Yourigh/A_light/4 - Mechanical/source_models_/esp8266-e12-1.snapshot.4/ESP8266 single.jpg

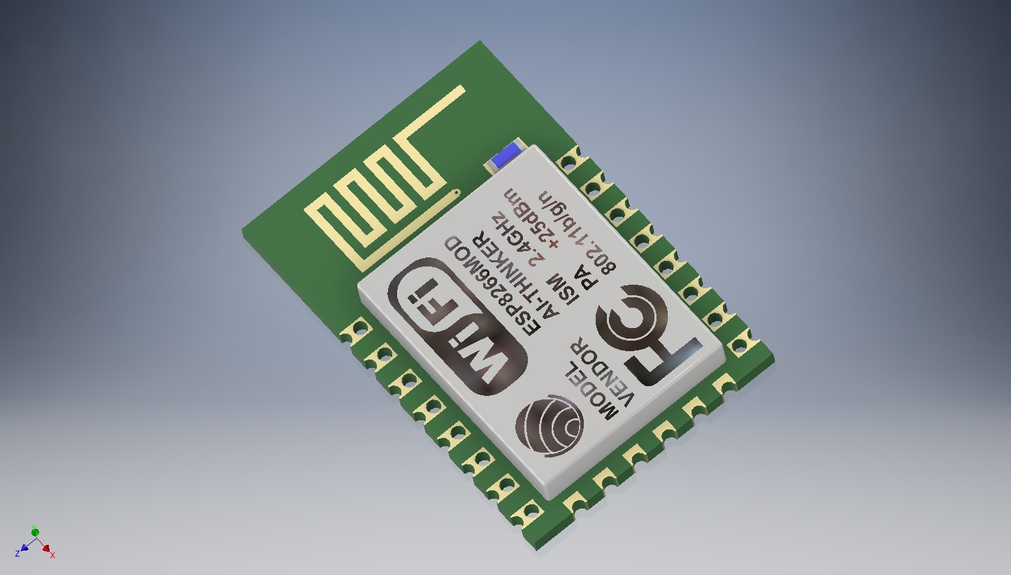
4 - Mechanical/source_models_/esp8266-e12-1.snapshot.4/ESP8266 single.jpg
