Yourigh/A_light/4 - Mechanical/source_models_/header-female-1.snapshot.4/Header Female 1x16.JPG

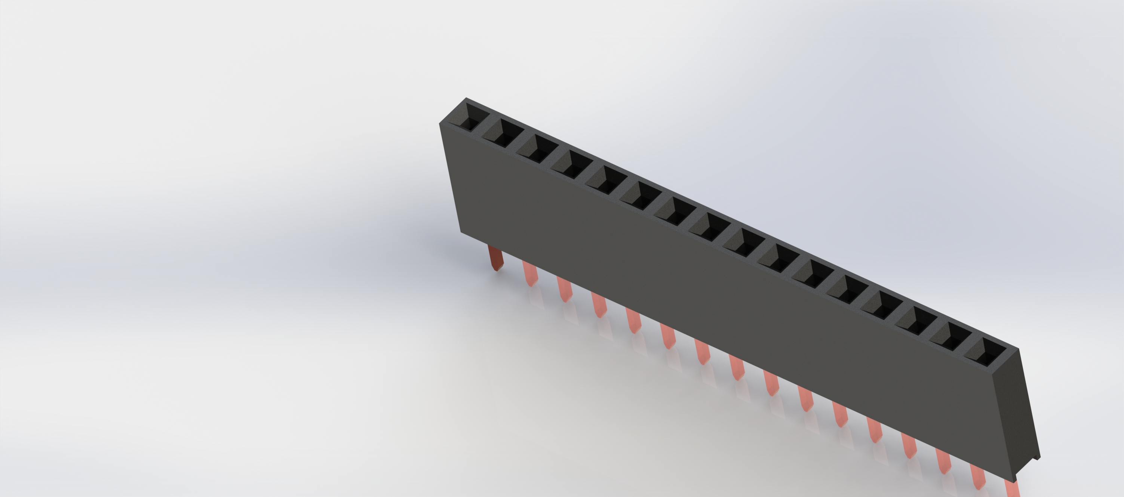
4 - Mechanical/source_models_/header-female-1.snapshot.4/Header Female 1x16.JPG
