Yourigh/A_light/4 - Mechanical/03ClockFace/clock face drawing v2.pdf

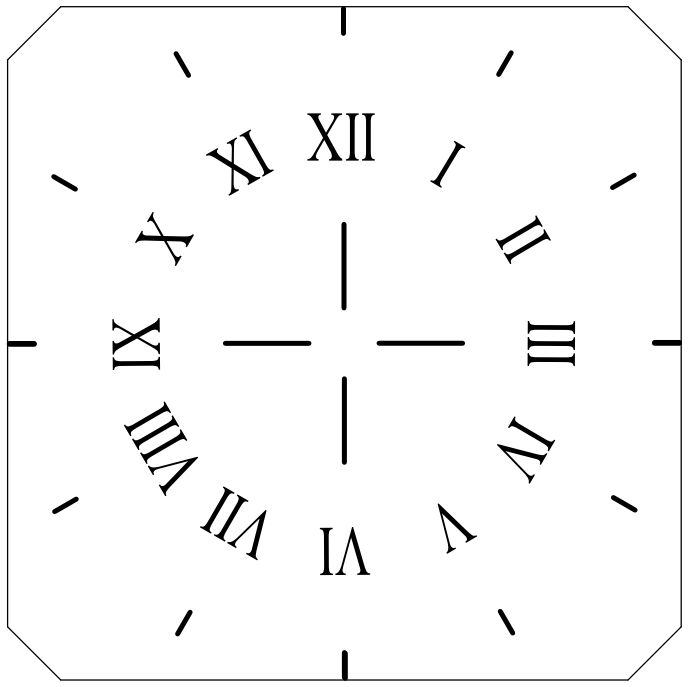
[picture p3: figure]
XII I; II III; VIII IX
