Yourigh/A_light/4 - Mechanical/03ClockFace/clock face drawing v3 latin.pdf

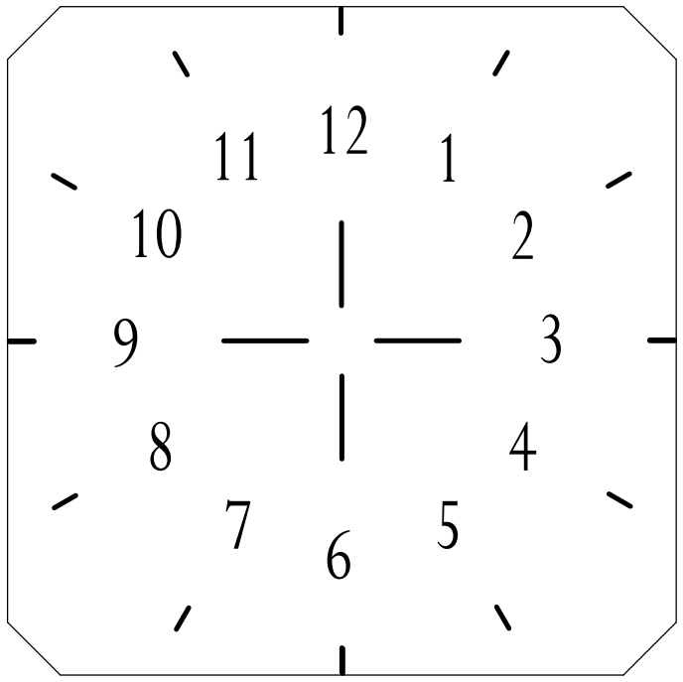
[picture p4: figure]
11 XII I; II III; VIII IX
