Yourigh/A_light/4 - Mechanical/03ClockFace/clock face drawing v3 lines.pdf

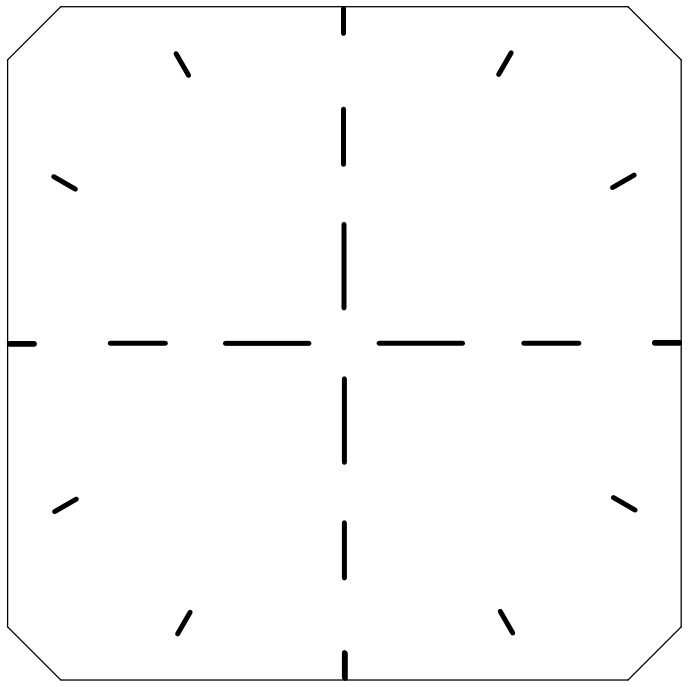
[picture p5: figure]
11 XII I; II III; VIII IX
