Yourigh/A_light/4 - Mechanical/03ClockFace/clock face drawing v3 transparency.pdf

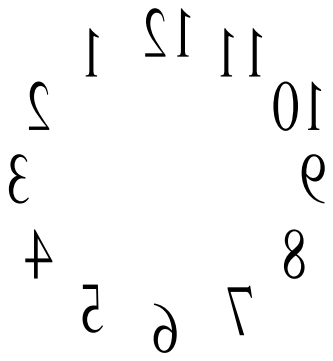
[picture p6: figure]
XII I; II III; VIII IX
