Yourigh/A_light/4 - Mechanical/03ClockFace/clock-face-drawing_small.png

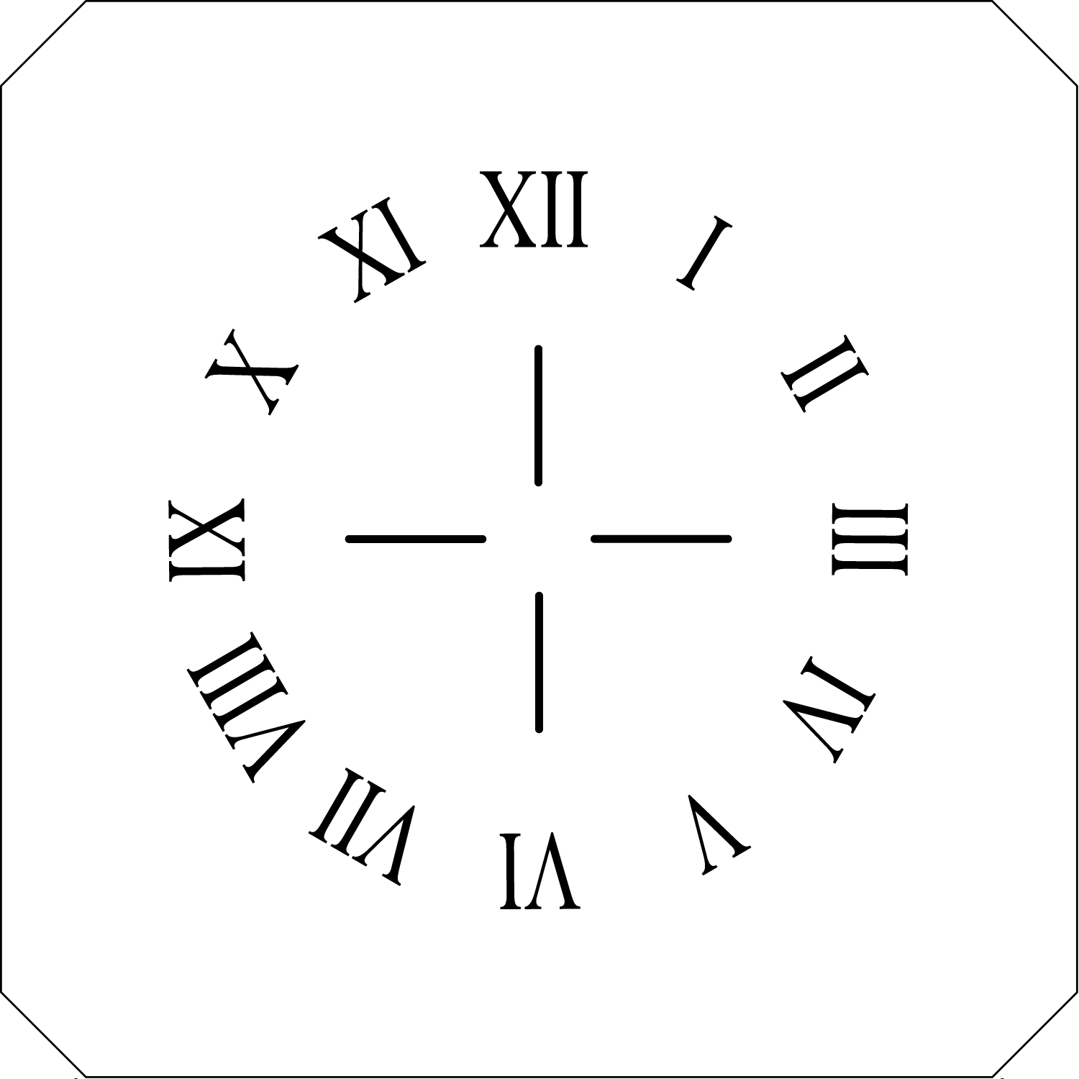
4 - Mechanical/03ClockFace/clock-face-drawing_small.png
