Yourigh/A_light/4 - Mechanical/source_models_/adafruit-24-led-neo-pixel-ring-1.snapshot.2/Renderings/24 neopixel.JPG

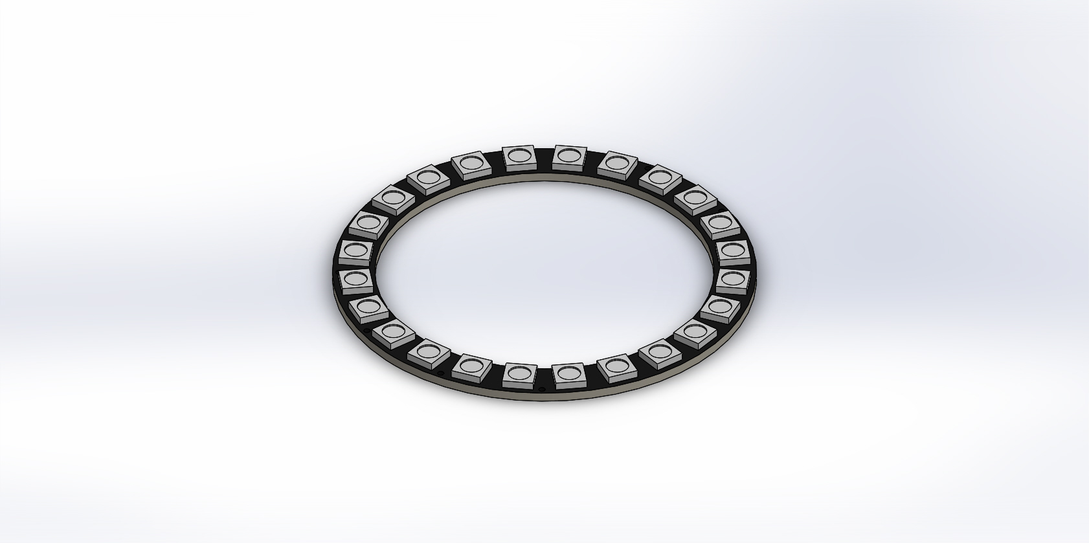
4 - Mechanical/source_models_/adafruit-24-led-neo-pixel-ring-1.snapshot.2/Renderings/24 neopixel.JPG
