Yourigh/A_light/4 - Mechanical/source_models_/adafruit-neopixel-ring-12x-ws2812-rgb-leds-1.snapshot.1/top.PNG

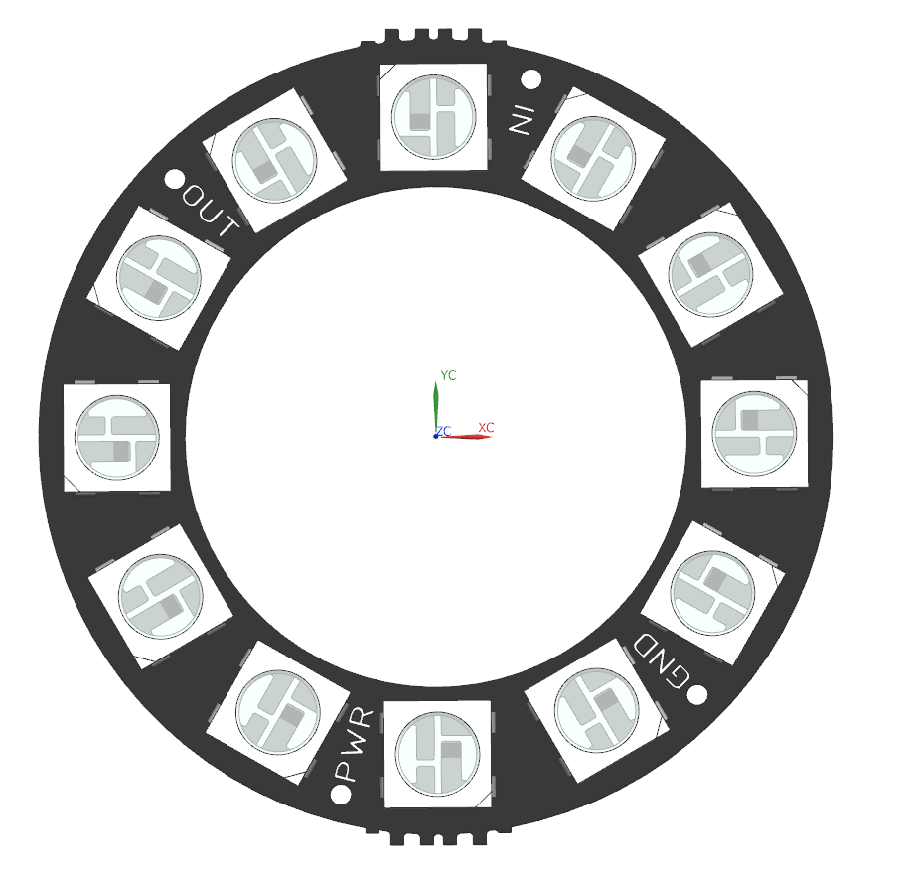
4 - Mechanical/source_models_/adafruit-neopixel-ring-12x-ws2812-rgb-leds-1.snapshot.1/top.PNG
