Yourigh/A_light/4 - Mechanical/source_models_/esp32-wroom-1.snapshot.2/ESP32-EWROOM.png

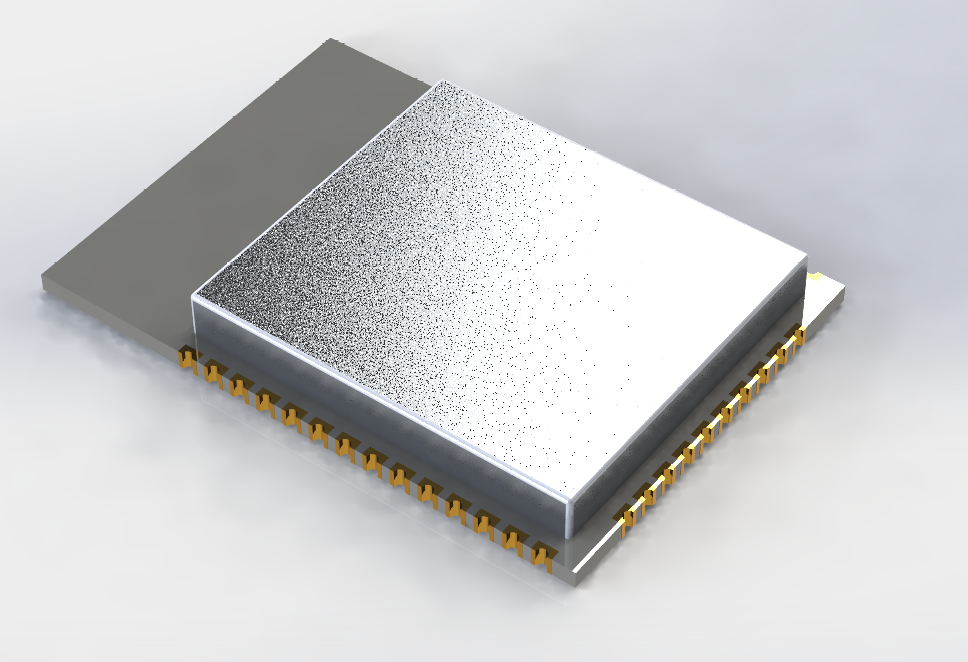
4 - Mechanical/source_models_/esp32-wroom-1.snapshot.2/ESP32-EWROOM.png
