Yourigh/A_light/4 - Mechanical/source_models_/header-female-1.snapshot.4/Renderings/Header Female 1x10.JPG

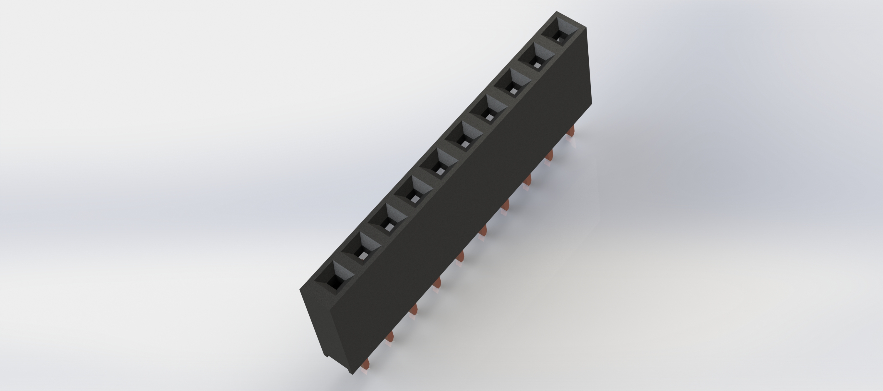
4 - Mechanical/source_models_/header-female-1.snapshot.4/Renderings/Header Female 1x10.JPG
