Yourigh/A_light/4 - Mechanical/source_models_/led-smd-rgb-ws2812-1.snapshot.1/LED - SMD RGB (WS2812).PNG

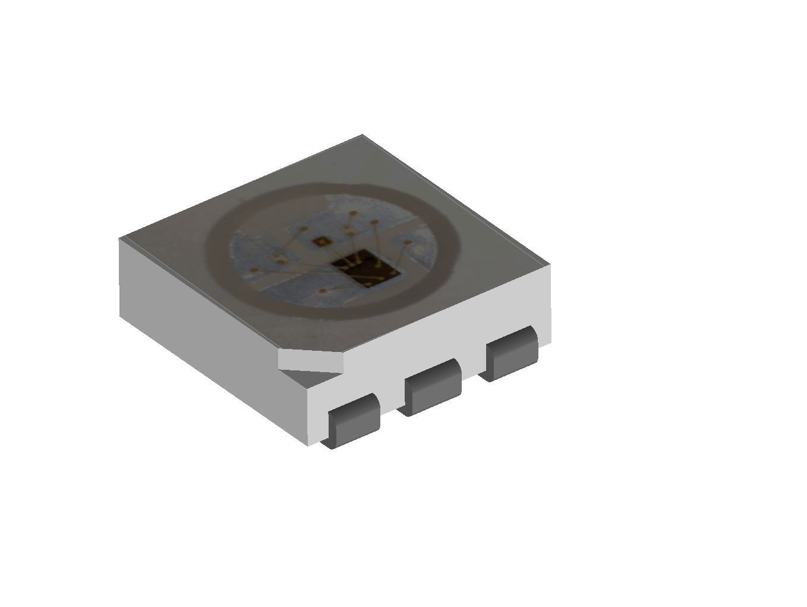
4 - Mechanical/source_models_/led-smd-rgb-ws2812-1.snapshot.1/LED - SMD RGB (WS2812).PNG
