Yourigh/A_light/4 - Mechanical/source_models_/micro-usb-dip-5-pin-pinboard-2-54mm-1.snapshot.3/MicroUSB_Pinboard_5_Pins_Back.JPG

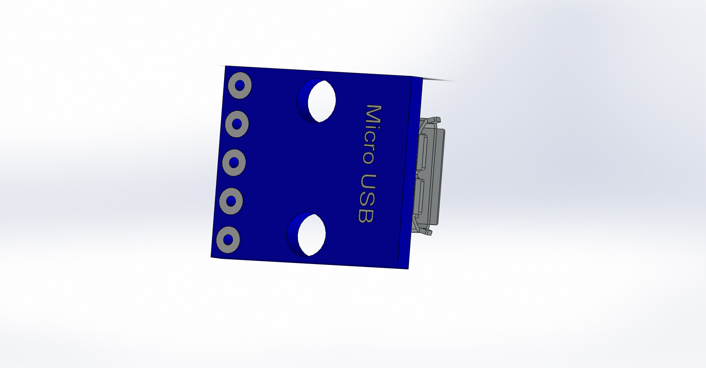
4 - Mechanical/source_models_/micro-usb-dip-5-pin-pinboard-2-54mm-1.snapshot.3/MicroUSB_Pinboard_5_Pins_Back.JPG
