Yourigh/A_light/2 - Electrical/0 - Development Drawings/2 - Main Board/2 - eeBOM/181229 Alight_eeBOM.xlsx

Sheet: OTHER_SPECIFICATIONS
Document Number and revision | Alight rev2
Document descrpition | Electrical bill of the material document for Alight rev2
Issued by | Juraj Repcik
Initial release date YY-MM-DD | 2018-12-29
Last modified by | Juraj Repcik
Last modified date date YY-MM-DD | 2018-12-29
Printed Circuit Board
PCB number and marking | -
Number of layers | 2
Material type | -
Temperature grade | -
Copper thickness | 18/35 um
Surface finishing | HAL
Soldermask TOP+BOTTOM | Green
Silkscreen - TOP | YES
Silkscreen - BOTTOM | YES
Silkscreen color | White
Electrical test | YES

Sheet: eeBOM ESP12 CH340
Qty | Value | Device | Supplier | Detail | Link | Price/pc USD | Price | Package | Parts | Description
9 | 0 | R-EU_R0603 | Farnell |  |  |  | 0 | R0603 | R8, R9, R13, R21, R22, R23, R24, R38, R55 | RESISTOR, European symbol
1 | 100k | R-EU_R0603 | Farnell |  |  |  | 0 | R0603 | R15 | RESISTOR, European symbol
8 | 100n | C-EUC0603K | Aliexpress |  | https://www.aliexpress.com/item/100pcs-1PF-10UF-0603-SMD-50V-X7R-10-100nf-104K-4-7UF-1UF-10UF-2-2UF/32883367230.html | 0.02 | 0.16 | C0603K | C1, C3, C5, C10, C13, C26, C28, C31 | CAPACITOR, European symbol
11 | 10u | C-EUC0603K | Aliexpress |  | https://www.aliexpress.com/item/100pcs-1PF-10UF-0603-SMD-50V-X7R-10-100nf-104K-4-7UF-1UF-10UF-2-2UF/32883367230.html | 0.02 | 0.22 | C0603K | C2, C4, C6, C9, C11, C12, C19, C20, C21, C22, C27 | CAPACITOR, European symbol
1 | 12MHz | CRYSTALSMD-HC49UP | Farnell | 1652551 | https://cz.farnell.com/abracon/abls-12-000mhz-b2-t/microprocessor-crystal-12mhz/dp/1652551 | 0.324 | 0.324 | HC49UP | Y1 | Crystals (Generic)
11 | 12k | R-EU_R0603 | Farnell |  |  |  | 0 | R0603 | R1, R2, R11, R16, R25, R26, R28, R30, R33, R41, R46 | RESISTOR, European symbol
1 | 2.2uH | L-EUL3225M | Farnell | 2871431 | https://cz.farnell.com/murata/dfe201210u-2r2m-p2/inductor-2-2uh-1-2a-20-wirewound/dp/2871431 | 0.533 | 0.533 | L3225M | L1 | INDUCTOR, European symbol
1 | 220k | R-EU_R0603 | Farnell |  |  |  | 0 | R0603 | R14 | RESISTOR, European symbol
3 | 220u | CPOL-EU153CLV-0605 | Farnell | 2611360 | https://cz.farnell.com/multicomp/mcvvt016m221ea6l/cap-220-f-16v-smd/dp/2611360 | 0.13 | 0.39 | 153CLV-0605 | C14, C15, C23 | POLARIZED CAPACITOR, European symbol
2 | 22p | C-EUC0402 | Farnell |  |  |  | 0 | C0402 | C7, C8 | CAPACITOR, European symbol
1 | 2M7 | R-EU_R0603 | Farnell |  |  |  | 0 | R0603 | R18 | RESISTOR, European symbol
2 | 2k2 | R-EU_R0603 | Farnell |  |  |  | 0 | R0603 | R27, R29 | RESISTOR, European symbol
1 | 32.768kHz | CRYSTAL-32.768KHZSMD-3.2X1.5 | Farnell | 2449398 | https://cz.farnell.com/iqd-frequency-products/lfxtal009678/crystal-32-768khz-12-5pf-smd/dp/2449398RL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 | 0.533 | 0.533 | CRYSTAL-SMD-3.2X1.5MM | Y2 | 32.768kHz Crystal
1 | 3V | BATTERY-20MM_PTH_KIT | Aliexpress |  | https://www.aliexpress.com/item/10pcs-lot-Black-Round-3V-CR2025-CR2032-Button-Coin-Cell-Battery-Socket-Holder-Case-Wholesale/32887016123.html | 0.085 | 0.085 | BATTCOM_20MM_PTH_KIT | BT1 | Battery - Single Cell
2 | 470 | R-EU_R0603 | Farnell |  |  |  | 0 | R0603 | R7, R10 | RESISTOR, European symbol
2 | 470p | C-EUC0603K | Farnell |  |  |  | 0 | C0603K | C16, C18 | CAPACITOR, European symbol
5 | 47k | R-EU_R0603 | Farnell |  |  |  | 0 | R0603 | R19, R34, R35, R36, R37 | RESISTOR, European symbol
2 | BAS17 | BAS17 | Farnell | 2889127 | https://cz.farnell.com/vishay/bas170ws-e3-08/diode-schottky-70v-sod-323/dp/2889127?st=bas17 | 0.29 | 0.58 | SOT23 | D3, D4 | Low-voltage stabistorLow-voltage stabilization diode in a small SOT23 plastic
2 | BC847 | BC847 | Farnell | 1081230 | https://cz.farnell.com/nexperia/bc847-215/transistor-bipol-npn-45v-sot-23/dp/1081230?st=bc847 | 0.13 | 0.26 | SOT23 | T1, T2 | NPN TRANSISTOR
1 | BUZZER-PTH_KIT_NO_SILK | BUZZER-PTH_KIT_NO_SILK | Aliexpress |  | https://www.aliexpress.com/item/10-Pcs-2Pin-Passive-Electronic-Alarm-Buzzer-12x8-5mm-12085-16Ohm-Resistance-3-5-9-12V/32883767629.html | 0.082 | 0.082 | BUZZER-12MM-NS-KIT | LS1 | Buzzer
1 | CH340G | CH340GSMD | Aliexpress |  | https://www.aliexpress.com/item/5PCS-Original-CH340G-SOP16-IC-R3-Board-Free-USB-Cable-Serial-Chip-SOP-16-CH340-SOP/32953600792.html | 0.316 | 0.316 | SO016 | U3 | A simple USB 2.0 to Serial IC.
1 | DS1307Z | DS1307Z | Aliexpress |  | https://www.aliexpress.com/item/10PCS-DS1307-DS1307Z-SOP-8-RTC-SERIAL-512K-I2C-Real-Time-Clock-IC/32832160593.html | 0.077 | 0.077 | SO08-0.15 | U1 | Maxim DS1307 - I2C Real-time clock (RTC)
1 | ESP12E/F | ESP8266-12EESP12E | Aliexpress | ESP12F | https://www.aliexpress.com/item/TZT-2018-New-version-1PCS-ESP-12F-ESP-12E-ESP8266-remote-serial-Port-WIFI-wireless-module/32647433505.html | 1.58 | 1.58 | ESP8266-ESP12E | SJR1 | ESP8266-12E Library for Eagle CAD
0 | FTDI | 6_PIN_SERIAL_TARGETLONGPADS |  |  |  |  | 0 | 1X06_LONGPADS | J1 | 6-pin header connection for use with the FTDI BASIC" pinout - TARGET SIDE."
1 | LDR | PINHD-1X2 | Aliexpress | 5528 | https://www.aliexpress.com/item/20PCS-LDR-Photo-Light-Sensitive-Resistor-Photoelectric-Photoresistor-5528-GL5528-5537-5506-5516-5539-5549-For/32760631393.html | 0.025 | 0.025 | 1X02 | LIGHT_DR | PIN HEADER
1 | LED_ring_24 / 12 | PINHD-1X4 | Farnell | 2779384 | https://cz.farnell.com/samtec/clh-104-f-d-dv/connector-rcpt-8pos-2row-2-54mm/dp/2779384 | 1.55 | 1.55 | 1X04 | LED_24 | PIN HEADER
0 | LM3671 | LM3671 | Farnell | 1008256 | https://cz.farnell.com/texas-instruments/lm3671adj/dc-dc-conv-adj-sot-23-5-powerwise/dp/1008256?st=LM3671 | 1.33 | 0 | SOT23-5 | U$1 | Texas Instruments LM3671, LM3671Q 2MHz, 600mA Step-Down DC-DC Converter
1 |  |  | Aliexpress |  | https://www.aliexpress.com/item/Free-shipping-10pcs-lot-LM3671MF-ADJ-LM3671MFX-ADJ-SBTB-regulator-IC-SOT23-5-new-original/32705400326.html | 0.386 | 0.386
1 | LMV611 | LMV611 | Farnell / personal stock | 2496280 | https://cz.farnell.com/texas-instruments/lmv611mf-nopb/op-amp-single-1-5mhz-0-42v-us/dp/2496280 | 0 | 0 | SC70-5L | IC2 | 1.8V, microPOWER CMOS OPERATIONAL AMPLIFIERS Zerø-Drift Series
1 | MMA8452QL | MMA8452QL | Aliexpress |  | https://www.aliexpress.com/item/5PCS-MMA8452QR1-QFN-MMA8452-QFN-16-8452-accelerometer-new-original/32956671576.html | 0.618 | 0.618 | QFN-16_0.5MM-EXTRA | U6 | MMA8452Q 3-Axis, 12/8-bit Digital Accelerometer
1 | USB | USB_MICRO-B_HALF_PTH_MILL | Farnell | 2293752 | https://cz.farnell.com/amphenol-icc-fci/10103594-0001lf/micro-usb-2-0-type-b-receptacle/dp/2293752 | 0.69 | 0.69 | USB-MICROB-PTH-MILL | J3 | USB Type Micro-B Connector
0 |  |  | Aliexpress alternative (USB tato) |  | https://www.aliexpress.com/item/20pcs-lot-5-Pin-SMT-Socket-Connector-Micro-USB-Type-B-Female-Placement-SMD-DIP-Socket/32795896266.html | 0.041 | 0
1 | WS2812B | WS2812B | Aliexpress | 10 pcs + white | https://www.aliexpress.com/item/10-1000pcs-WS2812B-Lamp-beads-5050-RGB-SMD-Black-White-version-WS2812-Individually-Addressable-Digital-LED/32963752520.html | 0.225 | 0.225 | WS2812B | D1 | WS2812B SMD addressable RGB LED
Components not on PCBA
Qty | Value | Device | Supplier | Detail | Link | Price/pc USD | Package | Parts | Description
1 | CR2032 | Battery CR2032 | Farnell
1 | TZT WS2812 12bit | LED ring 12 | Aliexpress | 12 Bit WS2812 | https://www.aliexpress.com/item/TZT-1pcs-RGB-LED-Ring-1Bit-8Bit-12Bit-16Bit-24Bit-WS2812-5050-RGB-LED-Integrated-Drivers/32787336145.html | 1.47
1 | TZT WS2812 12bit | LED ring 24 | Aliexpress | 24 Bit WS2812 | https://www.aliexpress.com/item/TZT-1pcs-RGB-LED-Ring-1Bit-8Bit-12Bit-16Bit-24Bit-WS2812-5050-RGB-LED-Integrated-Drivers/32787336145.html | 2.71
8 | 2mm dia bolts L=6.6..8.6mm | Ring hold
4 | 3mm dia bolts L=31..35mm | Box hold
4 | 3mm dia bolts L=5mm | PCB hold
