Yourigh/A_light/1 - System Docs/DEV_notes_REV2.xlsx

Sheet: changelog
 | 180609 | added summer_mode global bool var
 |  | added /wifioff http command
 |  | added manual summer mode, no wifi, activated by command
 |  | device will not be checking a connection when in summer mode
 | 191101 | Red middle indication if Wifi connection was lost
 | 200124 | changed step for brightness to 1s from 0.5s, now rise to full is in 4.2min
 |  | added external trigger interface and triggering on alarm
 |  | added external trigger to turn off the light on alarm timeout
V1.0 | 200205 | added more delays to ext trigger
 |  | //V1.1 added clock show yellow while in alarm shine mode
 | 20201222 | //V1.2 added internet time NTP client, added summer time commands and menu on default webpage

Sheet: HTTP commands
/restart
/a?update= | http_update_handle(req);
/cleareeprom - clears wifi login and alarms
/time - not implemented - getting time from time server, value returned to debug serial link only
/?SYN - writes time to device sent from http
 | Example: SYN,08+20+2016,09:28:56,1 - last number is day in the week starting Sunday = 1
/?ADD - adds alarm
 | //Example: /?ADD,2,A,0951,O,0,a
 |  | ?ADD,1,A,0825,234,0,name; HTTP/1.1 //234 means monday tuesday and wednesday repetition
/?DEL - deletes alarm
 | //Example: /?DEL,2 HTTP/1.1
/?SET - sets general parameters of a device like name
 | //Example: /?SET,5,Name+SecondWord
/?DEB - for debuggiing, not implemented
/a?ssid= - writing SSID and PASS to network
/wifioff | turns off wifi - summer mode!
/summertime_on
/summertime_off

Sheet: LightSense
LIGHT SENSING
 |  |  | divider par | XXX | divider par | 2700000 | 2M7
 |  | resistance | divider ser | 10000 | divider ser | 47000 | 47K
 | bright | 200 |  | 3.235294118 |  | 3.28601798
 |  | 400 |  | 3.173076923 |  | 3.272155989
 |  | 800 |  | 3.055555556 |  | 3.24478596
 |  | 1600 |  | 2.844827586 |  | 3.19142025
 |  | 3200 |  | 2.5 |  | 3.089874597
 |  | 6400 |  | 2.012195122 |  | 2.9053178
 |  | 12800 |  | 1.447368421 |  | 2.596267592
 |  | 25600 |  | 0.9269662921 |  | 2.143462635
 |  | 51200 |  | 0.5392156863 |  | 1.594905108
 |  | 102400 |  | 0.293594306 |  | 1.064820938
 | normal | 204800 |  | 0.1536312849 |  | 0.6534356628
 |  | 409600 |  | 0.07864632984 |  | 0.3852009055
 |  | 819200 |  | 0.03979739508 |  | 0.2296054958
 |  | 1638400 |  | 0.02001941276 |  | 0.1454075655
 |  | 3276800 |  | 0.01004016064 |  | 0.1015528376
 |  | 6553600 |  | 0.005027728685 |  | 0.07916502608
 |  | 13107200 |  | 0.002515780807 |  | 0.06785317847
 |  | 26214400 |  | 0.001258370068 |  | 0.06216740612
 | dark | 52428800 |  | 0.0006293050184 |  | 0.05931701182 | -0.002850394297
 | ADC resolution in volts
 | 0.00322265625
 |  |  | schematic
 |  |  |  |  | .+3.3V
 |  |  |  | 2M7 |  |  | sensor
 |  |  |  |  |  |  | OUT
 |  |  |  | 47K
 |  |  |  |  | GND

Sheet: Dig Filter lightsense
Light value filter
 | new | 2 | 3 | 0 | uint16_t exp_moving_average(uint16_t avg_in,uint16_t new_sample){
 |  |  | 0 | 1 | avg_in -= (avg_in >> 3); // div 8
 | 0 | 0 | 0 | 2 | avg_in += (new_sample >> 3);
 | 1024 | 0 | 128 | 3 | return avg_in;
 | 1024 | 112 | 240
 | 1024 | 210 | 338
 | 1024 | 295.75 | 423.75
 | 1024 | 370.78125 | 498.78125
 | 1024 | 436.4335938 | 564.4335938
 | 1024 | 493.8793945 | 621.8793945
 | 1024 | 544.1444702 | 672.1444702
 | 1024 | 588.1264114 | 716.1264114
 | 1024 | 626.61061 | 754.61061
 | 1024 | 660.2842838 | 788.2842838
 | 1024 | 689.7487483 | 817.7487483
 | 1024 | 715.5301548 | 843.5301548
 | 1024 | 738.0888854 | 866.0888854
 | 1024 | 757.8277747 | 885.8277747
 | 1024 | 775.0993029 | 903.0993029
 | 1024 | 790.21189 | 918.21189
 | 1024 | 803.4354038 | 931.4354038
 | 1024 | 815.0059783 | 943.0059783
 | 1024 | 825.130231 | 953.130231
 | 1024 | 833.9889521 | 961.9889521
 | 0 | 841.7403331 | 841.7403331
 | 0 | 736.5227915 | 736.5227915
 | 0 | 644.4574425 | 644.4574425
 | 0 | 563.9002622 | 563.9002622
 | 0 | 493.4127294 | 493.4127294
 | 0 | 431.7361383 | 431.7361383
 | 0 | 377.769121 | 377.769121
 | 0 | 330.5479809 | 330.5479809
 | 0 | 289.2294833 | 289.2294833
 | 0 | 253.0757978 | 253.0757978
 | 0 | 221.4413231 | 221.4413231
 | 0 | 193.7611577 | 193.7611577
 | 0 | 169.541013 | 169.541013
 | 0 | 148.3483864 | 148.3483864
 | 0 | 129.8048381 | 129.8048381
 | 0 | 113.5792333 | 113.5792333
 | 0 | 99.38182916 | 99.38182916
 | 0 | 86.95910051 | 86.95910051
 | 0 | 76.08921295 | 76.08921295
 | 0 | 66.57806133 | 66.57806133
 | 0 | 58.25580367 | 58.25580367
 | 0 | 50.97382821 | 50.97382821
 | 0 | 44.60209968 | 44.60209968
 | 0 | 39.02683722 | 39.02683722
 | 0 | 34.14848257 | 34.14848257
 | 0 | 29.87992225 | 29.87992225
 | 0 | 26.14493197 | 26.14493197
 | 0 | 22.87681547 | 22.87681547
 | 0 | 20.01721354 | 20.01721354
 | 0 | 17.51506184 | 17.51506184
 | 0 | 15.32567911 | 15.32567911
 | 0 | 13.40996922 | 13.40996922
 | 0 | 11.73372307 | 11.73372307
 | 0 | 10.26700769 | 10.26700769
 | 0 | 8.983631727 | 8.983631727
 | 0 | 7.860677761 | 7.860677761
 | 0 | 6.878093041 | 6.878093041
 | 0 | 6.018331411 | 6.018331411
 | 0 | 5.266039984 | 5.266039984
 | 0 | 4.607784986 | 4.607784986
 | 0 | 4.031811863 | 4.031811863
 | 0 | 3.52783538 | 3.52783538
 | 0 | 3.086855958 | 3.086855958
 | 0 | 2.700998963 | 2.700998963
 | 0 | 2.363374093 | 2.363374093

Sheet: LightSense 1901
LIGHT SENSING
 |  |  |  |  |  |  | R15 | 100000
 |  |  |  |  |  |  | R14 | 200000
 |  |  |  | divider par | XXX |  | R18 divider par | 10000000000 | 2M7
 |  |  | resistance LDR 5528 type | divider ser | 10000 |  | R19 divider ser | 4700 | 47K
 |  |  |  |  |  |  |  | div OUT | ADC in
 |  | bright | 600 |  | 3.113207547 |  |  | 2.926415114 | 0.9754717047
 |  |  | 900 |  | 3.027522936 |  |  | 2.769642897 | 0.9232142991
 |  |  | 1350 |  | 2.907488987 |  |  | 2.563636441 | 0.8545454803
 |  |  | 2025 |  | 2.744282744 |  |  | 2.306319843 | 0.7687732811
 |  |  | 3037.5 |  | 2.531160115 |  |  | 2.004523664 | 0.6681745546
 |  | normal | 4556.25 |  | 2.267067411 |  |  | 1.675624954 | 0.5585416513
 |  |  | 6834.375 |  | 1.960274735 |  |  | 1.344676784 | 0.4482255947
 |  |  | 10251.5625 |  | 1.629503896 |  |  | 1.037350504 | 0.3457835015
 |  |  | 15377.34375 |  | 1.300372503 |  |  | 0.772513459 | 0.2575044863
 |  |  | 23066.01562 |  | 0.9980035204 |  |  | 0.5585976011 | 0.1861992004
 |  |  | 34599.02344 |  | 0.7399265153 |  |  | 0.3946674978 | 0.1315558326
 |  |  | 51898.53516 |  | 0.5331305485 |  |  | 0.2740366649 | 0.09134555495
 |  |  | 77847.80273 |  | 0.3756496915 |  |  | 0.1878925102 | 0.06263083673
 |  |  | 116771.7041 |  | 0.2603104552 |  |  | 0.1276854904 | 0.04256183013
 |  |  | 175157.5562 |  | 0.1782265908 |  |  | 0.08623638007 | 0.02874546002
 |  | dark | 262736.3342 |  | 0.1209959798 |  |  | 0.05799660838 | 0.01933220279
 |  |  |  | schematic
 |  |  |  |  |  |  | .+3.3V
 |  |  |  |  |  | R18
 |  |  |  |  |  |  |  |  | sensor
 | ADC | divider R14+R15 |  | OUT
 |  |  |  |  |  |  | R19
 |  |  |  |  |  |  | GND

Sheet: RunningTailLight
TAIL LEDS | 6
FULL BR | 255
NUM_LEDS | 24
step | 42.5
step round | 42
brightness decay coef | 10
led begin | 12 | 1 for hours, 12 for minutes
dot | 4 |  | t | dot_loopback | dot_loopback-t | led_begin+dot_loopback-t | brightness | better brightness is used
 |  |  | 0 | 4 | 4 | 16 | 255 | 255
 |  |  | 1 | 4 | 3 | 15 | 213 | 23.18181818
 |  |  | 2 | 4 | 2 | 14 | 171 | 12.14285714
 |  |  | 3 | 4 | 1 | 13 | 129 | 8.225806452
 |  |  | 4 | 4 | 0 | 12 | 87 | 6.219512195
 |  |  | 5 | 28 | 23 | 35 | 45 | 5
 |  |  | 6 | 28 | 22 | 34 | 0 | 4.180327869
 |  |  | 7 |  |  |  |  | 3.591549296
 |  |  | 8 |  |  |  |  | 3.148148148
 |  |  | 9 |  |  |  |  | 2.802197802
 |  |  | 10 |  |  |  |  | 2.524752475
 |  |  | 11 |  |  |  |  | 2.297297297
 |  |  | 12 |  |  |  |  | 2.107438017
 |  |  | 13 |  |  |  |  | 1.946564885
 |  |  | 14 |  |  |  |  | 1.808510638
 |  |  | 15 |  |  |  |  | 1.688741722
 |  |  | 16 |  |  |  |  | 1.583850932
 |  |  | 17 |  |  |  |  | 1.49122807
 |  |  | 18 |  |  |  |  | 1.408839779
 |  |  | 19 |  |  |  |  | 1.335078534
 |  |  | 20 |  |  |  |  | 1.268656716

Sheet: PINOUTs
 | GPIO | NodeMCU | Use
HW I2C SCL | 0 | D3 | RTC
HW I2C SDA | 4 | D2 | RTC
Analog In | ADC0 | A0 | Light Sensor
 | 12 |  | LED Stripe
DIG out | 16 | D0 | On board LED
pull down | 15 | D8 | Boot to sketch after reset pull down / may not be necessary / restart does not work with this anyway
 |  | D5 | external device trigger DO | key 1
 |  | D14 | external device trigger DO | key 4
 |  | D15 | external device trigger DO | key 2
 |  | D16 | external device trigger DO | key ON/OFF

Sheet: Alarm_buffer
 | Alarm Array |  |  | EEPROM offset: |  | 256
index EEPROM | index | alarm ID
256 | 0 | 1 | Hour | byte | 0-23
257 | 1 | 1 | Minute | byte | 0-59
258 | 2 | 1 | Repeat | byte | 1010101 | each byte is a day. MSB is always 0, then Sunday to Monday LSB
259 | 3 | 1 | Setting | byte | 1 to 3 | non zero value means alarm active
260 | 4 | 2
261 | 5 | 2
262 | 6 | 2
263 | 7 | 2
264 | 8 | 3
265 | 9 | 3
266 | 10 | 3
267 | 11 | 3
268 | 12 | 4
269 | 13 | 4
270 | 14 | 4
271 | 15 | 4
272 | 16 | 5
273 | 17 | 5
274 | 18 | 5
275 | 19 | 5
276 | 20 | 6
277 | 21 | 6
278 | 22 | 6
279 | 23 | 6
280 | 24 | 7
281 | 25 | 7
282 | 26 | 7
283 | 27 | 7
284 | 28 | 8
285 | 29 | 8
286 | 30 | 8
287 | 31 | 8
288 | 32 | 9
289 | 33 | 9
290 | 34 | 9
291 | 35 | 9
292 | 36 | 10
293 | 37 | 10
294 | 38 | 10
295 | 39 | 10

Sheet: EEPROM parse
byte index | Caption | Format
0 | SSID WiFi | char | removed to zeros by cleareeprom
..
31
21 | PASS WiFi | char
..
95
..
256 | Alarm memory from alarm buffer | byte
..
296
300 | Summer time ON (0b1)/OFF (0b0) | byte
511

Sheet: HTTP_replace function
^@ | 0 |  | 0 | * |  | * | , | //0
^A | 1 |  | 1 | * |  | * | , | //1
^B | 2 |  | 2 | * |  | * | , | //2
^C | 3 |  | 3 | * |  | * | , | //3
^D | 4 |  | 4 | * |  | * | , | //4
^E | 5 |  | 5 | * |  | * | , | //5
^F | 6 |  | 6 | * |  | * | , | //6
^G | 7 |  | 7 | * |  | * | , | //7
^H | 8 |  | 8 | * |  | * | , | //8
^I | 9 |  | 9 | * |  | * | , | //9
^J | 10 |  | 10 | * |  | * | , | //10
^K | 11 |  | 11 | * |  | * | , | //11
^L | 12 |  | 12 | * |  | * | , | //12
^M | 13 |  | 13 | * |  | * | , | //13
^N | 14 |  | 14 | * |  | * | , | //14
^O | 15 |  | 15 | * |  | * | , | //15
^P | 16 |  | 16 | * |  | * | , | //16
^Q | 17 |  | 17 | * |  | * | , | //17
^R | 18 |  | 18 | * |  | * | , | //18
^S | 19 |  | 19 | * |  | * | , | //19
^T | 20 |  | 20 | * |  | * | , | //20
^U | 21 |  | 21 | * |  | * | , | //21
^V | 22 |  | 22 | * |  | * | , | //22
^W | 23 |  | 23 | * |  | * | , | //23
^X | 24 |  | 24 | * |  | * | , | //24
^Y | 25 |  | 25 | * |  | * | , | //25
^Z | 26 |  | 26 | * |  | * | , | //26
^[ | 27 |  | 27 | * |  | * | , | //27
^\ | 28 |  | 28 | * |  | * | , | //28
^] | 29 |  | 29 | * |  | * | , | //29
^^ | 30 |  | 30 | * |  | * | , | //30
^_ | 31 |  | 31 | * |  | * | , | //31
 | 32 |  | 32 | * |  | * | , | //32
! | 33 | ! | 33 | * | ! | * | , | //33
" | 34 | " | 34 | * | " | * | , | //34
# | 35 | # | 35 | * | # | * | , | //35
$ | 36 | $ | 36 | * | $ | * | , | //36
% | 37 | % | 37 | * | % | * | , | //37
& | 38 | & | 38 | * | & | * | , | //38
' | 39 | ' | 39 | * | ' | * | , | //39
( | 40 | ( | 40 | * | ( | * | , | //40
) | 41 | ) | 41 | * | ) | * | , | //41
* | 42 | * | 42 | * | * | * | , | //42
+ | 43 | + | 43 | * | + | * | , | //43
, | 44 | , | 44 | * | , | * | , | //44
- | 45 | - | 45 | * | - | * | , | //45
. | 46 | . | 46 | * | . | * | , | //46
/ | 47 | / | 47 | * | / | * | , | //47
0 | 48 | 0 | 48 | * | 0 | * | , | //48
1 | 49 | 1 | 49 | * | 1 | * | , | //49
2 | 50 | 2 | 50 | * | 2 | * | , | //50
3 | 51 | 3 | 51 | * | 3 | * | , | //51
4 | 52 | 4 | 52 | * | 4 | * | , | //52
5 | 53 | 5 | 53 | * | 5 | * | , | //53
6 | 54 | 6 | 54 | * | 6 | * | , | //54
7 | 55 | 7 | 55 | * | 7 | * | , | //55
8 | 56 | 8 | 56 | * | 8 | * | , | //56
9 | 57 | 9 | 57 | * | 9 | * | , | //57
: | 58 | : | 58 | * | : | * | , | //58
; | 59 | ; | 59 | * | ; | * | , | //59
< | 60 | < | 60 | * | < | * | , | //60
= | 61 | = | 61 | * | = | * | , | //61
> | 62 | > | 62 | * | > | * | , | //62
? | 63 | ? | 63 | * | ? | * | , | //63
@ | 64 | @ | 64 | * | @ | * | , | //64
A | 65 | A | 65 | * | A | * | , | //65
B | 66 | B | 66 | * | B | * | , | //66
C | 67 | C | 67 | * | C | * | , | //67
D | 68 | D | 68 | * | D | * | , | //68
E | 69 | E | 69 | * | E | * | , | //69
F | 70 | F | 70 | * | F | * | , | //70
G | 71 | G | 71 | * | G | * | , | //71
H | 72 | H | 72 | * | H | * | , | //72
I | 73 | I | 73 | * | I | * | , | //73
J | 74 | J | 74 | * | J | * | , | //74
K | 75 | K | 75 | * | K | * | , | //75
L | 76 | L | 76 | * | L | * | , | //76
M | 77 | M | 77 | * | M | * | , | //77
N | 78 | N | 78 | * | N | * | , | //78
O | 79 | O | 79 | * | O | * | , | //79
P | 80 | P | 80 | * | P | * | , | //80
Q | 81 | Q | 81 | * | Q | * | , | //81
R | 82 | R | 82 | * | R | * | , | //82
S | 83 | S | 83 | * | S | * | , | //83
T | 84 | T | 84 | * | T | * | , | //84
U | 85 | U | 85 | * | U | * | , | //85
V | 86 | V | 86 | * | V | * | , | //86
W | 87 | W | 87 | * | W | * | , | //87
X | 88 | X | 88 | * | X | * | , | //88
Y | 89 | Y | 89 | * | Y | * | , | //89
Z | 90 | Z | 90 | * | Z | * | , | //90
[ | 91 | [ | 91 | * | [ | * | , | //91
\ | 92 | \ | 92 | * | \ | * | , | //92
] | 93 | ] | 93 | * | ] | * | , | //93
^ | 94 | ^ | 94 | * | ^ | * | , | //94
_ | 95 | _ | 95 | * | _ | * | , | //95
` | 96 | ` | 96 | * | ` | * | , | //96
a | 97 | a | 97 | * | a | * | , | //97
b | 98 | b | 98 | * | b | * | , | //98
c | 99 | c | 99 | * | c | * | , | //99
d | 100 | d | 100 | * | d | * | , | //100
e | 101 | e | 101 | * | e | * | , | //101
f | 102 | f | 102 | * | f | * | , | //102
g | 103 | g | 103 | * | g | * | , | //103
h | 104 | h | 104 | * | h | * | , | //104
i | 105 | i | 105 | * | i | * | , | //105
j | 106 | j | 106 | * | j | * | , | //106
k | 107 | k | 107 | * | k | * | , | //107
l | 108 | l | 108 | * | l | * | , | //108
m | 109 | m | 109 | * | m | * | , | //109
n | 110 | n | 110 | * | n | * | , | //110
o | 111 | o | 111 | * | o | * | , | //111
p | 112 | p | 112 | * | p | * | , | //112
q | 113 | q | 113 | * | q | * | , | //113
r | 114 | r | 114 | * | r | * | , | //114
s | 115 | s | 115 | * | s | * | , | //115
t | 116 | t | 116 | * | t | * | , | //116
u | 117 | u | 117 | * | u | * | , | //117
v | 118 | v | 118 | * | v | * | , | //118
w | 119 | w | 119 | * | w | * | , | //119
x | 120 | x | 120 | * | x | * | , | //120
y | 121 | y | 121 | * | y | * | , | //121
z | 122 | z | 122 | * | z | * | , | //122
{ | 123 | { | 123 | * | { | * | , | //123
| | 124 | | | 124 | * | | | * | , | //124
} | 125 | } | 125 | * | } | * | , | //125
~ | 126 | ~ | 126 | * | ~ | * | , | //126
 | 127 |  | 127 | * |  | * | , | //127
€ | 128 | € | 128 | * | € | * | , | //128
 | 129 |  | 129 | * |  | * | , | //129
‚ | 130 | ‚ | 130 | * | ‚ | * | , | //130
ƒ | 131 | ƒ | 131 | * | ƒ | * | , | //131
„ | 132 | „ | 132 | * | „ | * | , | //132
… | 133 | … | 133 | * | … | * | , | //133
† | 134 | † | 134 | * | † | * | , | //134
‡ | 135 | ‡ | 135 | * | ‡ | * | , | //135
ˆ | 136 | ˆ | 136 | * | ˆ | * | , | //136
‰ | 137 | ‰ | 137 | * | ‰ | * | , | //137
Š | 138 | Š | 138 | * | Š | * | , | //138
‹ | 139 | ‹ | 139 | * | ‹ | * | , | //139
Œ | 140 | Œ | 140 | * | Œ | * | , | //140
 | 141 |  | 141 | * |  | * | , | //141
Ž | 142 | Ž | 142 | * | Ž | * | , | //142
 | 143 |  | 143 | * |  | * | , | //143
 | 144 |  | 144 | * |  | * | , | //144
‘ | 145 | ‘ | 145 | * | ‘ | * | , | //145
’ | 146 | ’ | 146 | * | ’ | * | , | //146
“ | 147 | “ | 147 | * | “ | * | , | //147
” | 148 | ” | 148 | * | ” | * | , | //148
• | 149 | • | 149 | * | • | * | , | //149
– | 150 | – | 150 | * | – | * | , | //150
— | 151 | — | 151 | * | — | * | , | //151
˜ | 152 | ˜ | 152 | * | ˜ | * | , | //152
™ | 153 | ™ | 153 | * | ™ | * | , | //153
š | 154 | š | 154 | * | š | * | , | //154
› | 155 | › | 155 | * | › | * | , | //155
œ | 156 | œ | 156 | * | œ | * | , | //156
 | 157 |  | 157 | * |  | * | , | //157
ž | 158 | ž | 158 | * | ž | * | , | //158
Ÿ | 159 | Ÿ | 159 | * | Ÿ | * | , | //159
 | 160 |  | 160 | * |  | * | , | //160
¡ | 161 | ¡ | 161 | * | ¡ | * | , | //161
¢ | 162 | ¢ | 162 | * | ¢ | * | , | //162
£ | 163 | £ | 163 | * | £ | * | , | //163
¤ | 164 | ¤ | 164 | * | ¤ | * | , | //164
¥ | 165 | ¥ | 165 | * | ¥ | * | , | //165
¦ | 166 | ¦ | 166 | * | ¦ | * | , | //166
§ | 167 | § | 167 | * | § | * | , | //167
¨ | 168 | ¨ | 168 | * | ¨ | * | , | //168
© | 169 | © | 169 | * | © | * | , | //169
ª | 170 | ª | 170 | * | ª | * | , | //170
« | 171 | « | 171 | * | « | * | , | //171
¬ | 172 | ¬ | 172 | * | ¬ | * | , | //172
 | 173 |  | 173 | * |  | * | , | //173
® | 174 | ® | 174 | * | ® | * | , | //174
¯ | 175 | ¯ | 175 | * | ¯ | * | , | //175
° | 176 | ° | 176 | * | ° | * | , | //176
± | 177 | ± | 177 | * | ± | * | , | //177
² | 178 | ² | 178 | * | ² | * | , | //178
³ | 179 | ³ | 179 | * | ³ | * | , | //179
´ | 180 | ´ | 180 | * | ´ | * | , | //180
µ | 181 | µ | 181 | * | µ | * | , | //181
¶ | 182 | ¶ | 182 | * | ¶ | * | , | //182
· | 183 | · | 183 | * | · | * | , | //183
¸ | 184 | ¸ | 184 | * | ¸ | * | , | //184
¹ | 185 | ¹ | 185 | * | ¹ | * | , | //185
º | 186 | º | 186 | * | º | * | , | //186
» | 187 | » | 187 | * | » | * | , | //187
¼ | 188 | ¼ | 188 | * | ¼ | * | , | //188
½ | 189 | ½ | 189 | * | ½ | * | , | //189
¾ | 190 | ¾ | 190 | * | ¾ | * | , | //190
¿ | 191 | ¿ | 191 | * | ¿ | * | , | //191
À | 192 | À | 192 | * | À | * | , | //192
Á | 193 | Á | 193 | * | Á | * | , | //193
Â | 194 | Â | 194 | * | Â | * | , | //194
Ã | 195 | Ã | 195 | * | Ã | * | , | //195
Ä | 196 | Ä | 196 | * | Ä | * | , | //196
Å | 197 | Å | 197 | * | Å | * | , | //197
Æ | 198 | Æ | 198 | * | Æ | * | , | //198
Ç | 199 | Ç | 199 | * | Ç | * | , | //199
È | 200 | È | 200 | * | È | * | , | //200
É | 201 | É | 201 | * | É | * | , | //201
Ê | 202 | Ê | 202 | * | Ê | * | , | //202
Ë | 203 | Ë | 203 | * | Ë | * | , | //203
Ì | 204 | Ì | 204 | * | Ì | * | , | //204
Í | 205 | Í | 205 | * | Í | * | , | //205
Î | 206 | Î | 206 | * | Î | * | , | //206
Ï | 207 | Ï | 207 | * | Ï | * | , | //207
Ð | 208 | Ð | 208 | * | Ð | * | , | //208
Ñ | 209 | Ñ | 209 | * | Ñ | * | , | //209
Ò | 210 | Ò | 210 | * | Ò | * | , | //210
Ó | 211 | Ó | 211 | * | Ó | * | , | //211
Ô | 212 | Ô | 212 | * | Ô | * | , | //212
Õ | 213 | Õ | 213 | * | Õ | * | , | //213
Ö | 214 | Ö | 214 | * | Ö | * | , | //214
× | 215 | × | 215 | * | × | * | , | //215
Ø | 216 | Ø | 216 | * | Ø | * | , | //216
Ù | 217 | Ù | 217 | * | Ù | * | , | //217
Ú | 218 | Ú | 218 | * | Ú | * | , | //218
Û | 219 | Û | 219 | * | Û | * | , | //219
Ü | 220 | Ü | 220 | * | Ü | * | , | //220
Ý | 221 | Ý | 221 | * | Ý | * | , | //221
Þ | 222 | Þ | 222 | * | Þ | * | , | //222
ß | 223 | ß | 223 | * | ß | * | , | //223
à | 224 | à | 224 | * | à | * | , | //224
á | 225 | á | 225 | * | á | * | , | //225
â | 226 | â | 226 | * | â | * | , | //226
ã | 227 | ã | 227 | * | ã | * | , | //227
ä | 228 | ä | 228 | * | ä | * | , | //228
å | 229 | å | 229 | * | å | * | , | //229
æ | 230 | æ | 230 | * | æ | * | , | //230
ç | 231 | ç | 231 | * | ç | * | , | //231
è | 232 | è | 232 | * | è | * | , | //232
é | 233 | é | 233 | * | é | * | , | //233
ê | 234 | ê | 234 | * | ê | * | , | //234
ë | 235 | ë | 235 | * | ë | * | , | //235
ì | 236 | ì | 236 | * | ì | * | , | //236
í | 237 | í | 237 | * | í | * | , | //237
î | 238 | î | 238 | * | î | * | , | //238
ï | 239 | ï | 239 | * | ï | * | , | //239
ð | 240 | ð | 240 | * | ð | * | , | //240
ñ | 241 | ñ | 241 | * | ñ | * | , | //241
ò | 242 | ò | 242 | * | ò | * | , | //242
ó | 243 | ó | 243 | * | ó | * | , | //243
ô | 244 | ô | 244 | * | ô | * | , | //244
õ | 245 | õ | 245 | * | õ | * | , | //245
ö | 246 | ö | 246 | * | ö | * | , | //246
÷ | 247 | ÷ | 247 | * | ÷ | * | , | //247
ø | 248 | ø | 248 | * | ø | * | , | //248
ù | 249 | ù | 249 | * | ù | * | , | //249
ú | 250 | ú | 250 | * | ú | * | , | //250
û | 251 | û | 251 | * | û | * | , | //251
ü | 252 | ü | 252 | * | ü | * | , | //252
ý | 253 | ý | 253 | * | ý | * | , | //253
þ | 254 | þ | 254 | * | þ | * | , | //254
ÿ | 255 | ÿ | 255 | * | ÿ | * | , | //255

Sheet: TODO
TODO
Increase the buzzer volume - probably a boost converter
Nut holding the PCB should be interted from the other side or the part
Re-consider location of light sensor
Feedback from schematics
dni R on DO from light ring
