Yourigh/A_light/2 - Electrical/0 - Development Drawings/2 - Main Board/4 - Assembly Drawings/Alight_main_board_v2.SLDPRT

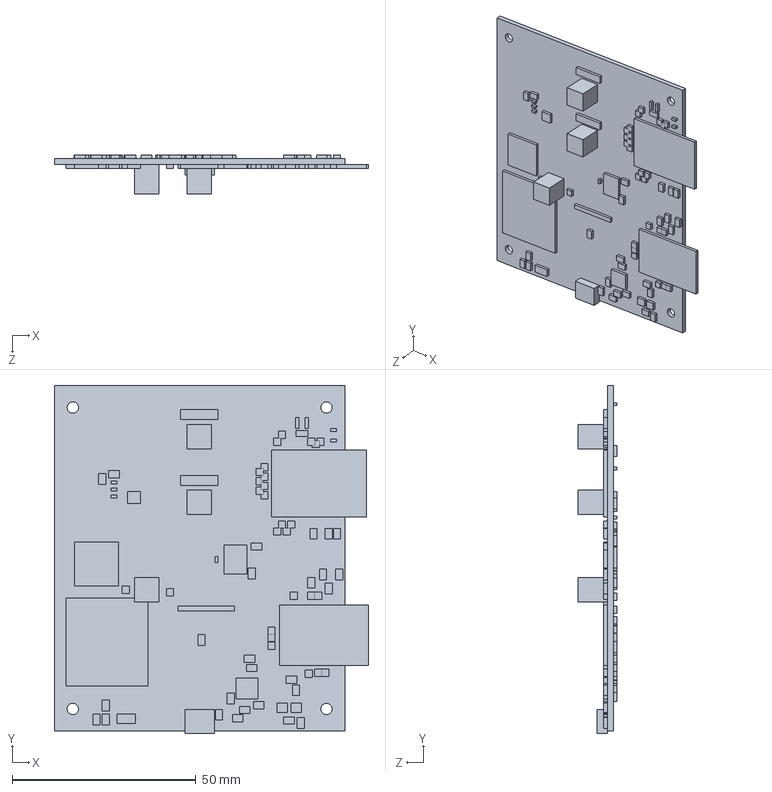
[picture p24: CAD file, 2020-11-07]
2 - Electrical/0 - Development Drawings/2 - Main Board/4 - Assembly Drawings/Alight_main_board_v2.SLDPRT
85.4 x 94.7 x 10.6 mm
