Yourigh/A_light/4 - Mechanical/02Export/MainPCB.DXF

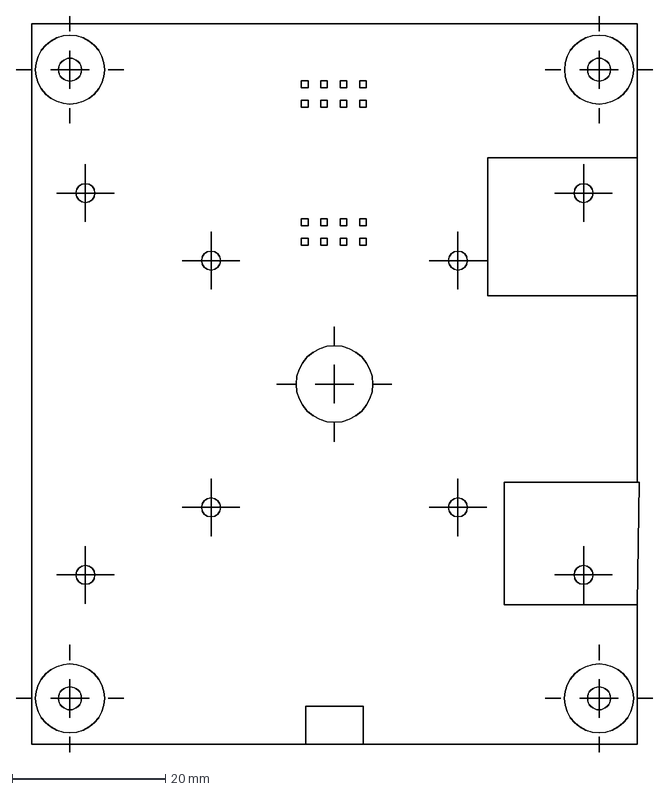
[picture p25: CAD file, 2020-11-07]
4 - Mechanical/02Export/MainPCB.DXF
83.0 x 96.0 mm
