Yourigh/A_light/4 - Mechanical/01Design/MainPCB.SLDPRT

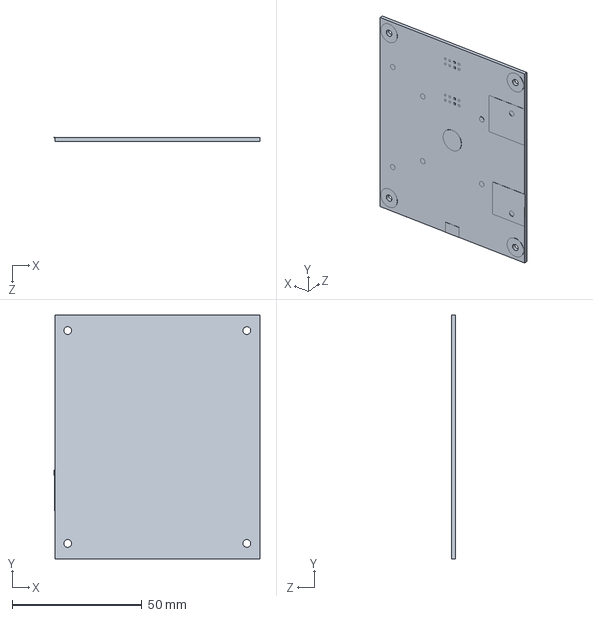
[picture p26: CAD file, 2020-11-07]
4 - Mechanical/01Design/MainPCB.SLDPRT
79.2 x 94.0 x 1.70 mm
