Yourigh/A_light/4 - Mechanical/01Design/Box start nn.SLDASM

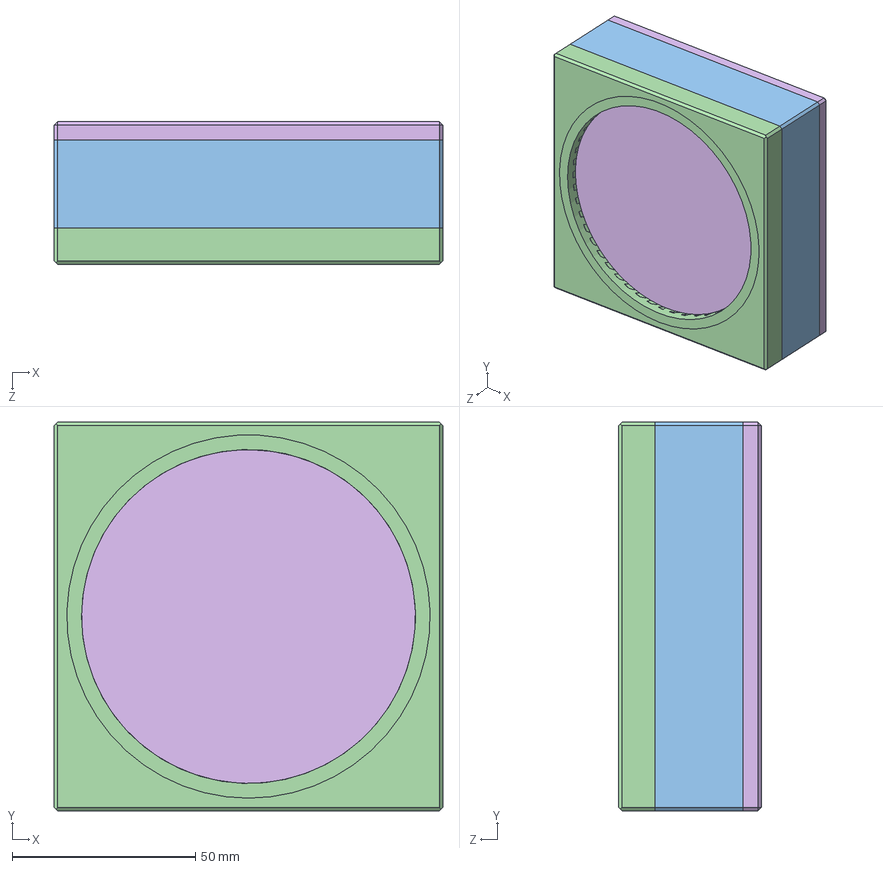
[picture p27: CAD file, 2020-11-07]
4 - Mechanical/01Design/Box start nn.SLDASM
106.0 x 106.0 x 39.0 mm
LED ring 12 TZT
LED ring 24 TZT v2
Box back
Box cover front
Box cover front ring
Box back cover
ESP8266 single
SSM_104_L_DV x 2
esp32wroom
MicroUSB_5_Pins
Alight_main_board_v2
Box Front paper
