Yourigh/A_light/4 - Mechanical/01Design/LED ring 24 TZT.SLDASM

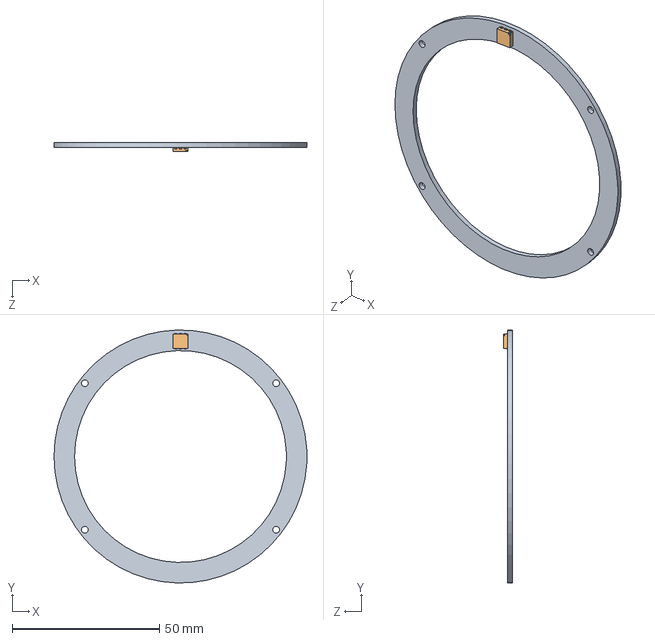
[picture p28: CAD file, 2020-11-07]
4 - Mechanical/01Design/LED ring 24 TZT.SLDASM
86.0 x 86.0 x 3.20 mm
LED 24 PCB
LED - SMD RGB (WS2812)
