Yourigh/A_light/4 - Mechanical/01Design/LED ring 24 TZT v2.SLDASM

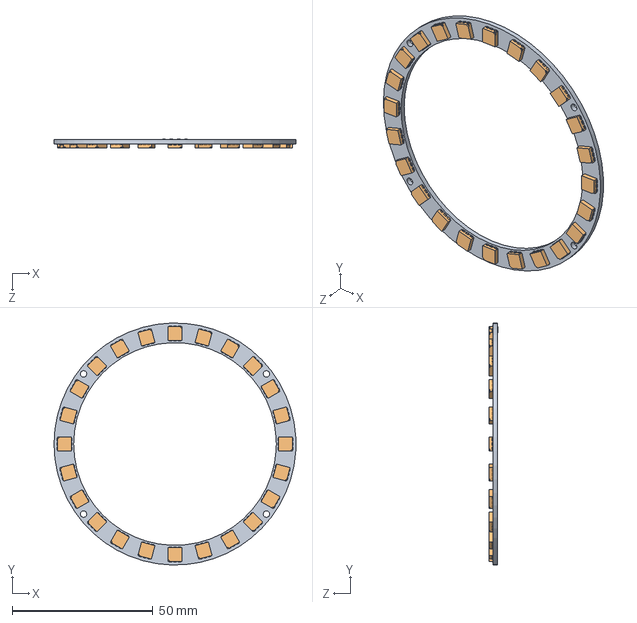
[picture p29: CAD file, 2020-11-07]
4 - Mechanical/01Design/LED ring 24 TZT v2.SLDASM
86.0 x 86.0 x 3.20 mm
LED 24 PCB
LED - SMD RGB (WS2812) x 24
