Yourigh/A_light/4 - Mechanical/01Design/LED ring 12 TZT.SLDASM

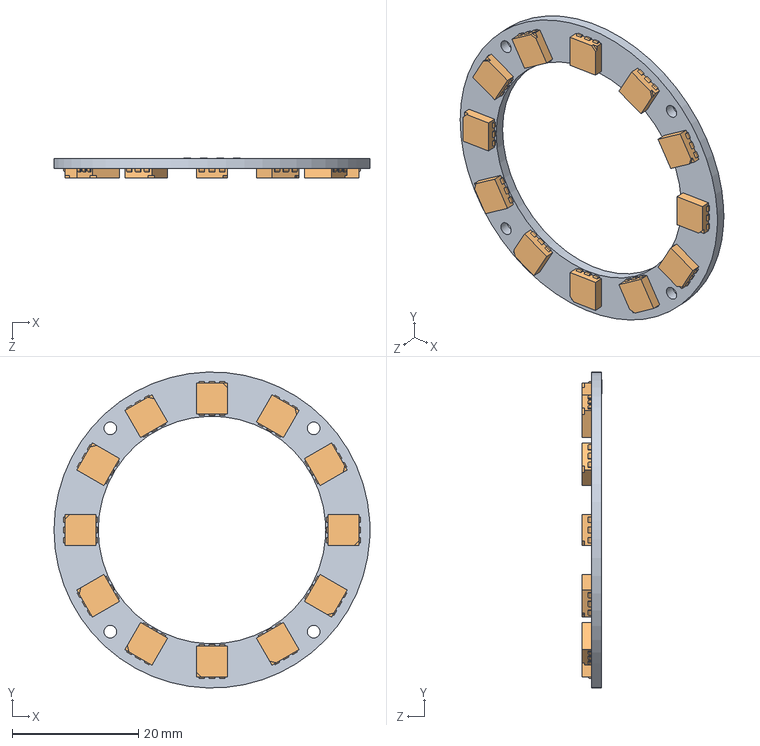
[picture p30: CAD file, 2020-11-07]
4 - Mechanical/01Design/LED ring 12 TZT.SLDASM
50.0 x 50.0 x 3.20 mm
LED 12 PCB
LED - SMD RGB (WS2812) x 12
