Yourigh/A_light/4 - Mechanical/01Design/Box back cover.SLDPRT

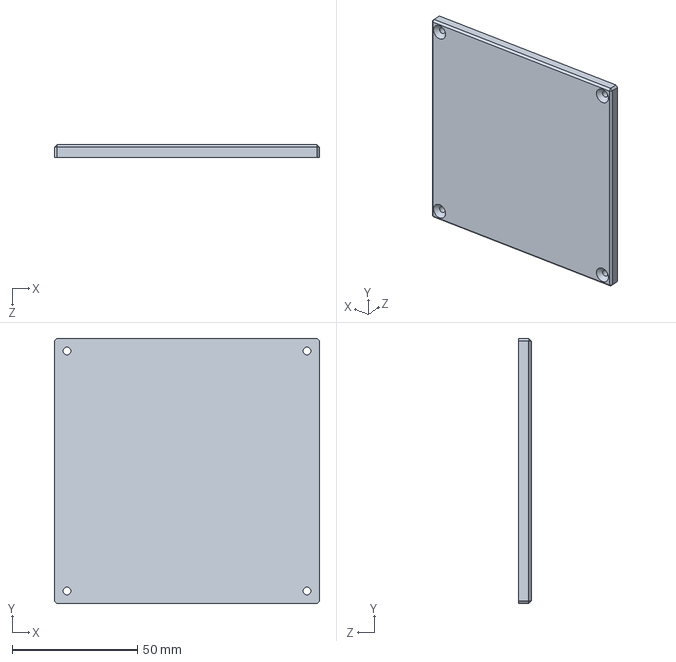
[picture p31: CAD file, 2020-11-07]
4 - Mechanical/01Design/Box back cover.SLDPRT
106.0 x 106.0 x 5.00 mm
