Yourigh/A_light/4 - Mechanical/01Design/Submodels/MicroUSB_5_Pins.SLDPRT

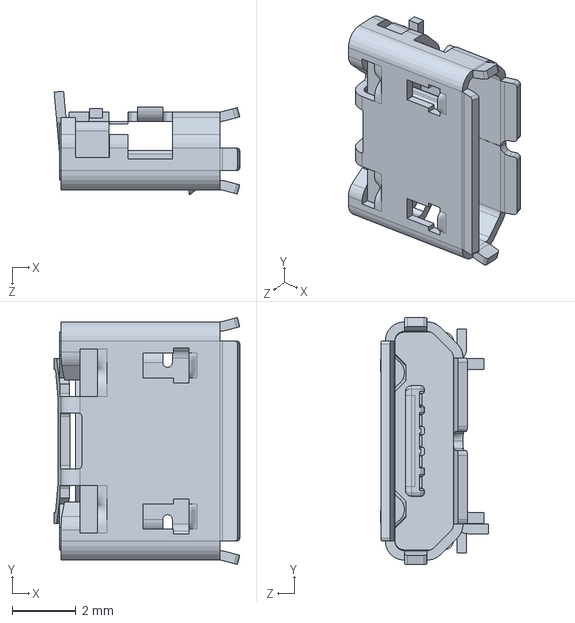
[picture p32: CAD file, 2020-11-07]
4 - Mechanical/01Design/Submodels/MicroUSB_5_Pins.SLDPRT
5.84 x 7.77 x 3.40 mm
