Yourigh/A_light/4 - Mechanical/02Export/181228 final3 clock/Box back v3.SLDPRT

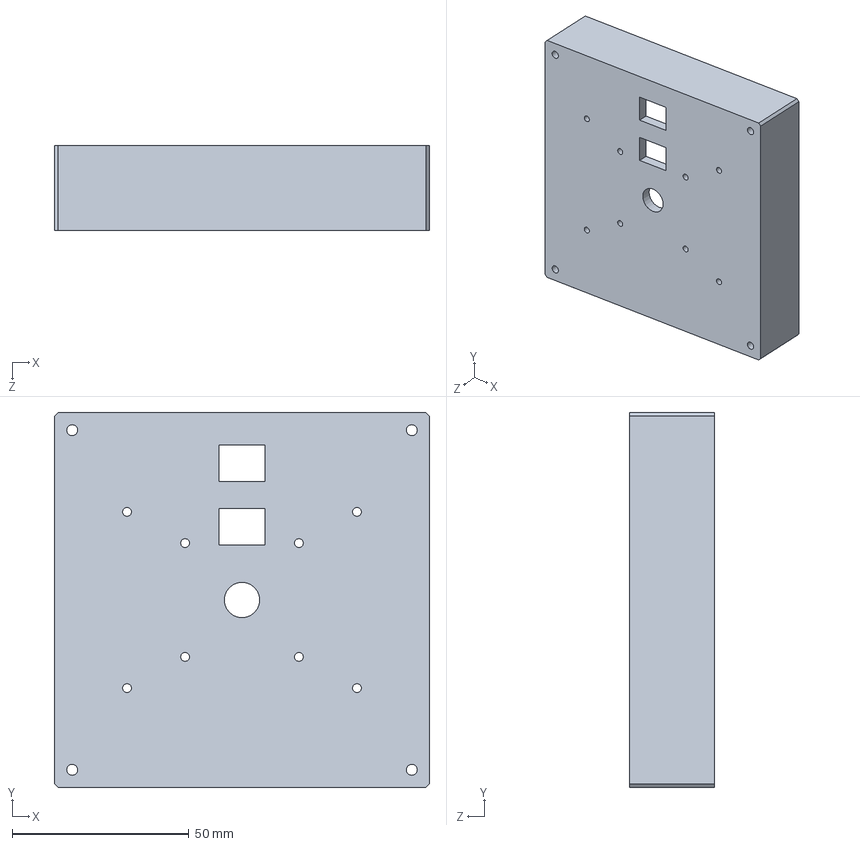
[picture p33: CAD file, 2020-11-07]
4 - Mechanical/02Export/181228 final3 clock/Box back v3.SLDPRT
106.0 x 106.0 x 24.0 mm
