Yourigh/A_light/4 - Mechanical/02Export/190724 final4 FRA/Box cover front.STL

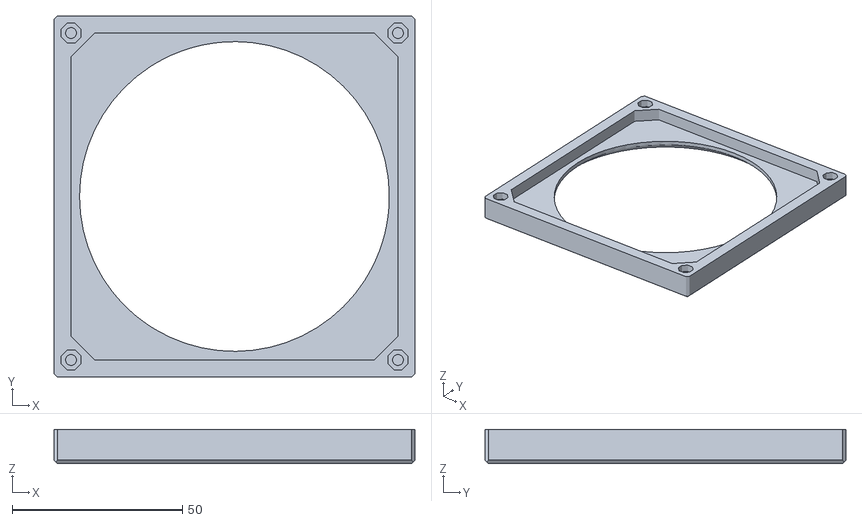
[picture p34: CAD file, 2020-11-07]
4 - Mechanical/02Export/190724 final4 FRA/Box cover front.STL
106.0 x 106.0 x 10.0
