Yourigh/A_light/4 - Mechanical/source_models_/adafruit-24-led-neo-pixel-ring-1.snapshot.2/24 neopixel.SLDPRT

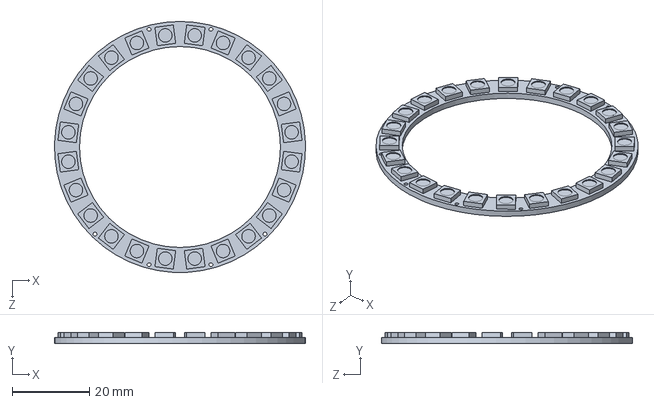
[picture p35: CAD file, 2020-11-07]
4 - Mechanical/source_models_/adafruit-24-led-neo-pixel-ring-1.snapshot.2/24 neopixel.SLDPRT
65.0 x 2.75 x 65.0 mm
