Yourigh/A_light/4 - Mechanical/source_models_/adafruit-neopixel-ring-12x-ws2812-rgb-leds-1.snapshot.1/Adafruit neopixel ring.stp

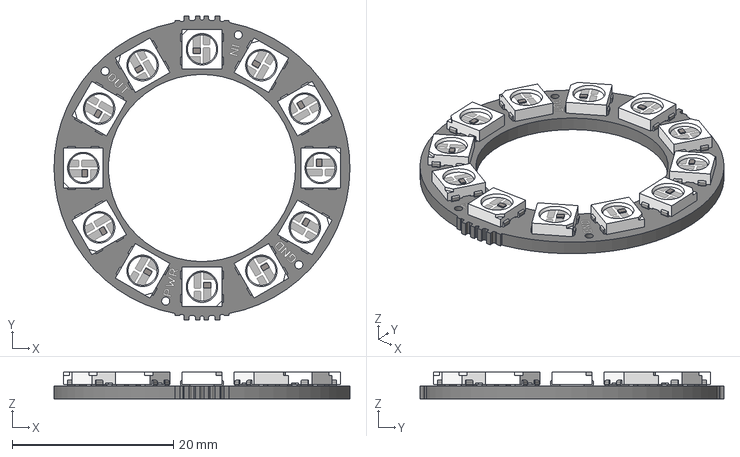
[picture p36: CAD file, 2020-11-07]
4 - Mechanical/source_models_/adafruit-neopixel-ring-12x-ws2812-rgb-leds-1.snapshot.1/Adafruit neopixel ring.stp
36.7 x 37.7 x 3.31 mm
