Yourigh/A_light/4 - Mechanical/source_models_/esp32-wroom-1.snapshot.2/esp32wroom.SLDPRT

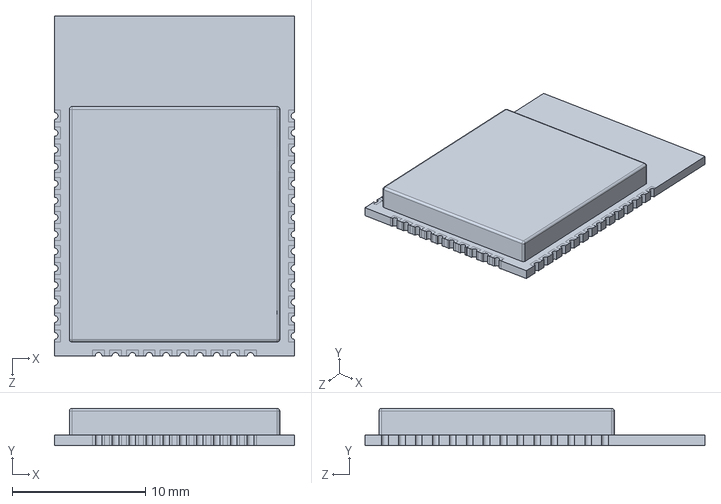
[picture p37: CAD file, 2020-11-07]
4 - Mechanical/source_models_/esp32-wroom-1.snapshot.2/esp32wroom.SLDPRT
18.0 x 2.81 x 25.5 mm
