Yourigh/A_light/4 - Mechanical/source_models_/esp8266-e12-1.snapshot.4/ESP8266 single.SLDPRT

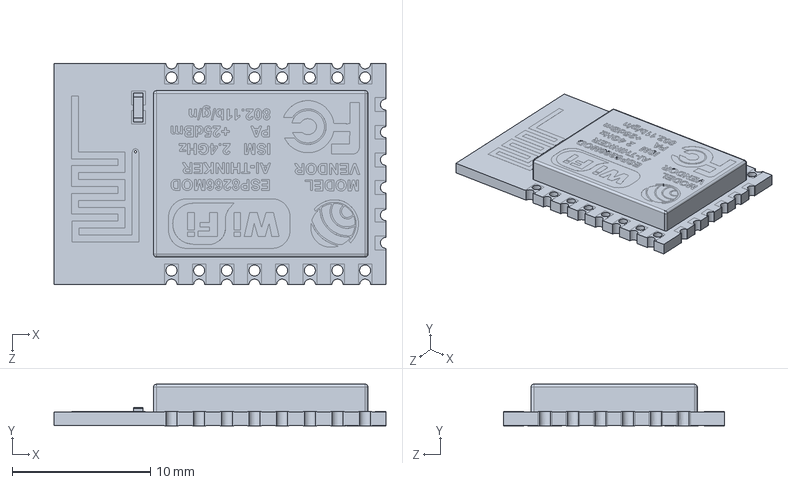
[picture p38: CAD file, 2020-11-07]
4 - Mechanical/source_models_/esp8266-e12-1.snapshot.4/ESP8266 single.SLDPRT
24.0 x 3.01 x 16.0 mm
