Yourigh/A_light/4 - Mechanical/source_models_/header-female-1.snapshot.4/Header Female 1x16.STEP

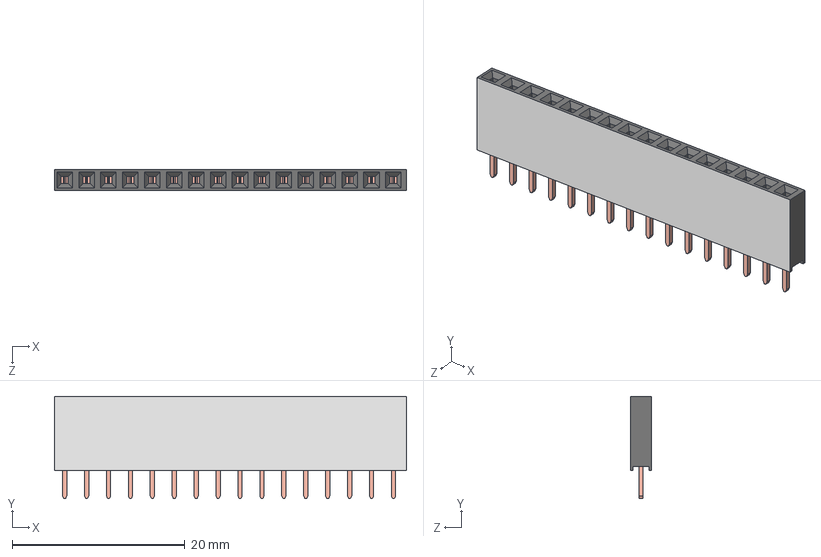
[picture p39: CAD file, 2020-11-07]
4 - Mechanical/source_models_/header-female-1.snapshot.4/Header Female 1x16.STEP
40.8 x 11.9 x 2.48 mm
