Yourigh/A_light/4 - Mechanical/source_models_/led-smd-rgb-ws2812-1.snapshot.1/LED - SMD RGB (WS2812).sldprt

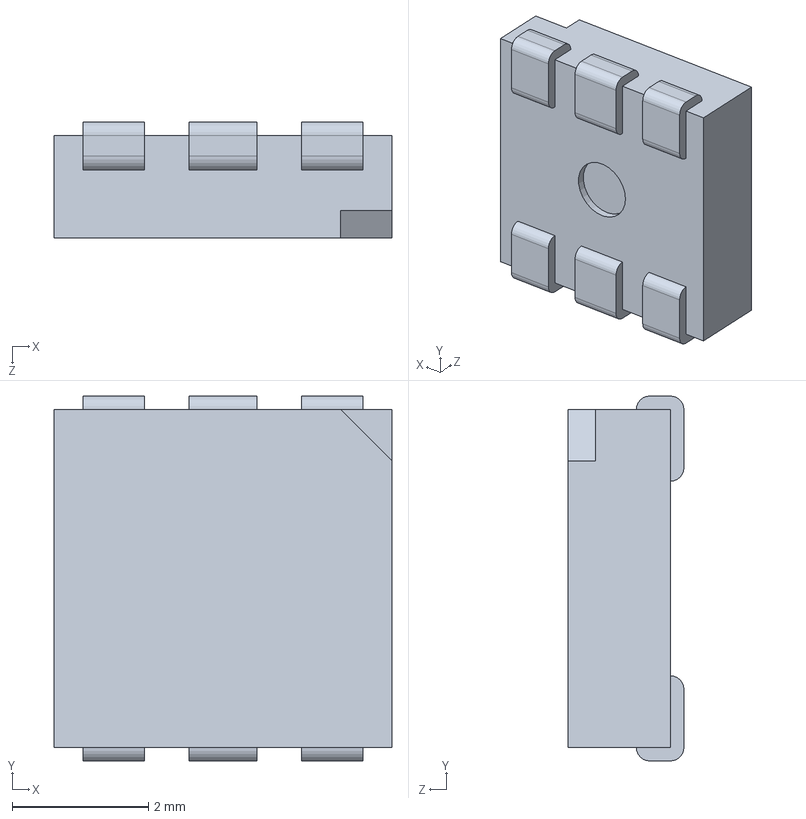
[picture p40: CAD file, 2020-11-07]
4 - Mechanical/source_models_/led-smd-rgb-ws2812-1.snapshot.1/LED - SMD RGB (WS2812).sldprt
4.95 x 5.35 x 1.70 mm
