Yourigh/A_light/4 - Mechanical/source_models_/micro-usb-dip-5-pin-pinboard-2-54mm-1.snapshot.3/MicroUSB_Pinboard_5_Pins.SLDPRT

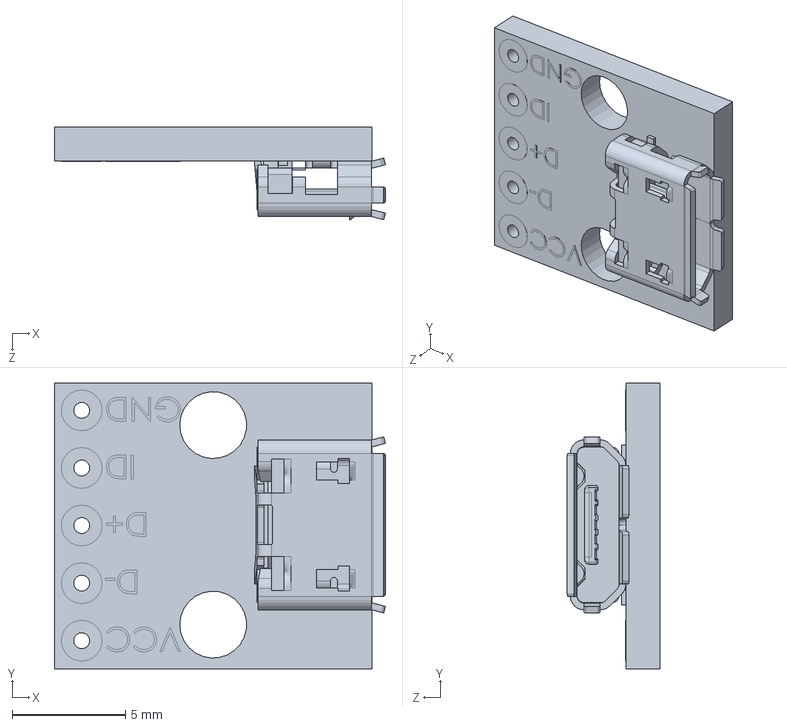
[picture p41: CAD file, 2020-11-07]
4 - Mechanical/source_models_/micro-usb-dip-5-pin-pinboard-2-54mm-1.snapshot.3/MicroUSB_Pinboard_5_Pins.SLDPRT
14.6 x 12.6 x 4.11 mm
