Yourigh/A_light/4 - Mechanical/source_models_/neopixel-ring-24x-1.snapshot.6/Neopixels_ring_x24.STEP

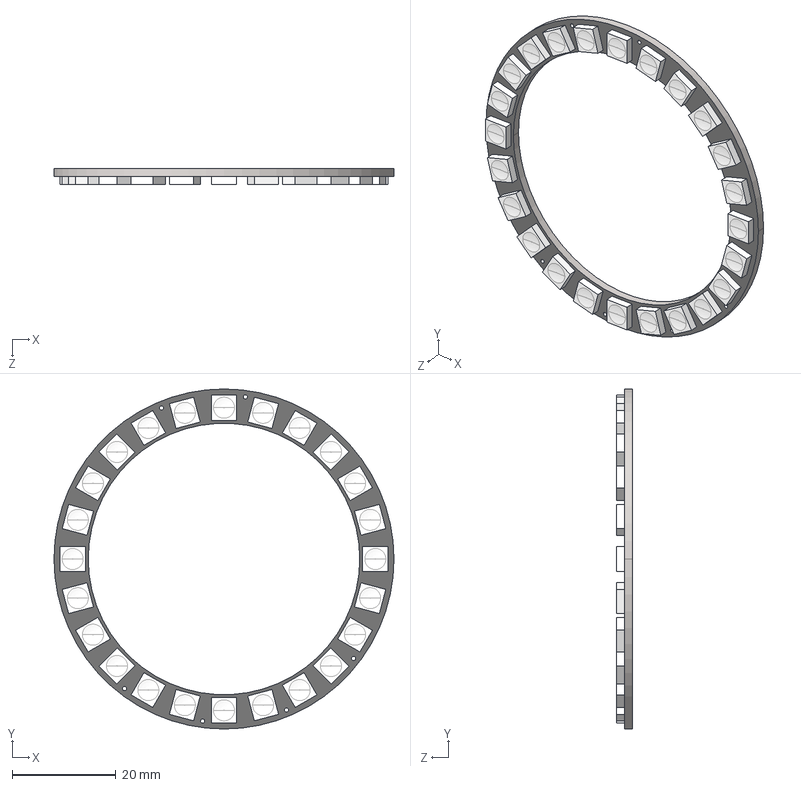
[picture p42: CAD file, 2020-11-07]
4 - Mechanical/source_models_/neopixel-ring-24x-1.snapshot.6/Neopixels_ring_x24.STEP
65.5 x 65.5 x 3.18 mm
