Yourigh/A_light/4 - Mechanical/02Export/181226 final2 clock parts print/Box cover front ring.SLDPRT

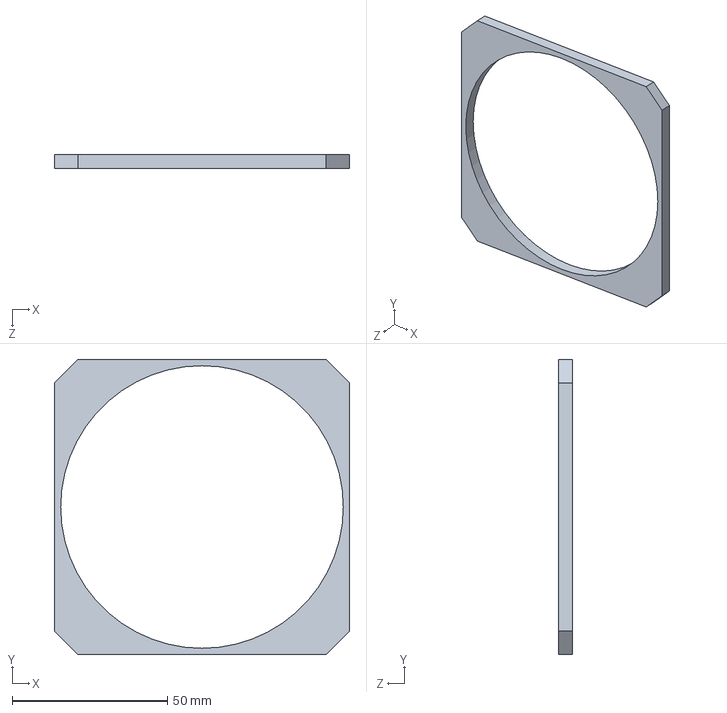
[picture p43: CAD file, 2020-11-07]
4 - Mechanical/02Export/181226 final2 clock parts print/Box cover front ring.SLDPRT
95.0 x 95.0 x 4.50 mm
