Yourigh/A_light/4 - Mechanical/02Export/181228 final3 clock/Box cover front.STL

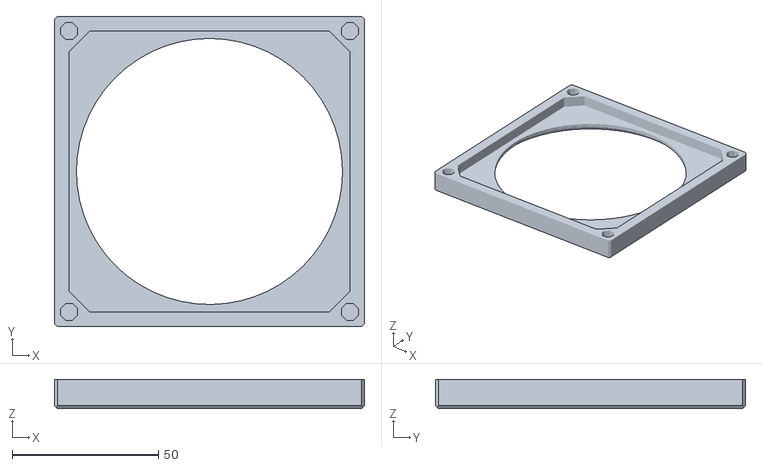
[picture p44: CAD file, 2020-11-07]
4 - Mechanical/02Export/181228 final3 clock/Box cover front.STL
106.0 x 106.0 x 10.0
