Yourigh/A_light/4 - Mechanical/01Design/Submodels/SSM_104_L_DV.SLDPRT

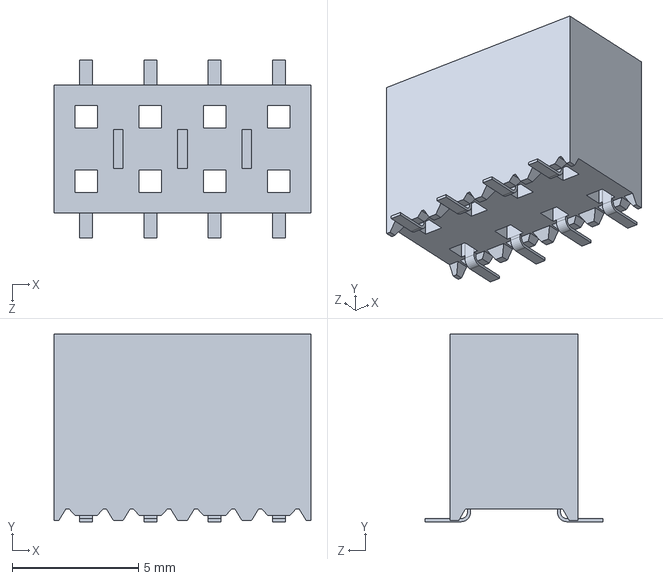
[picture p46: CAD file, 2020-11-07]
4 - Mechanical/01Design/Submodels/SSM_104_L_DV.SLDPRT
10.2 x 7.42 x 7.04 mm
