Yourigh/A_light/4 - Mechanical/01Design/Submodels/LED 24 PCB.SLDPRT

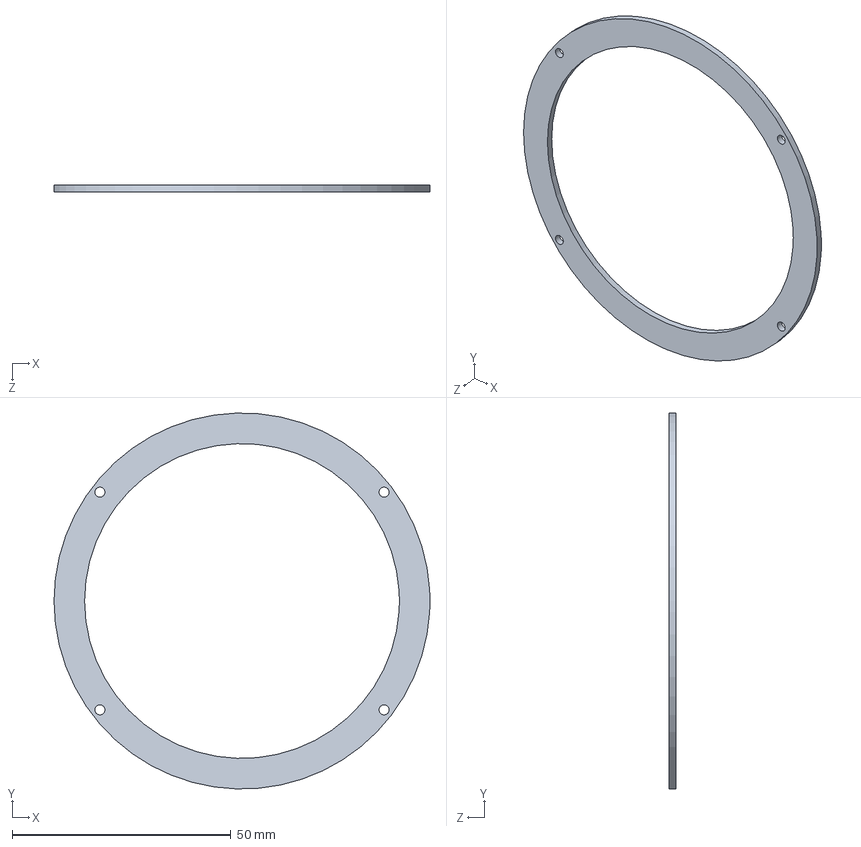
[picture p47: CAD file, 2020-11-07]
4 - Mechanical/01Design/Submodels/LED 24 PCB.SLDPRT
86.0 x 86.0 x 1.70 mm
