Yourigh/A_light/4 - Mechanical/01Design/Submodels/LED 12 PCB.SLDPRT

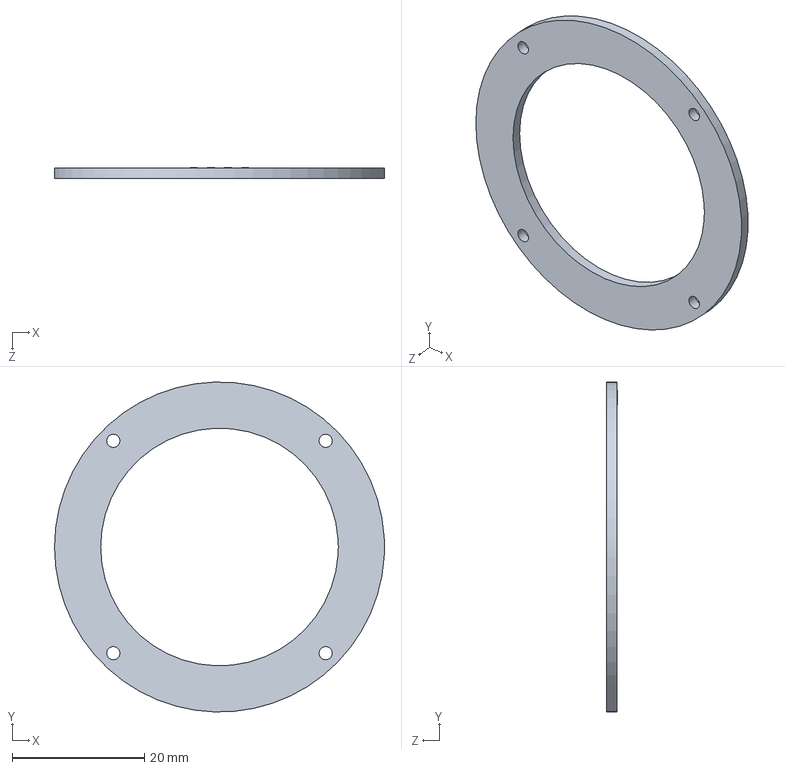
[picture p48: CAD file, 2020-11-07]
4 - Mechanical/01Design/Submodels/LED 12 PCB.SLDPRT
50.0 x 50.0 x 1.70 mm
