Yourigh/A_light/4 - Mechanical/01Design/Box Front paper.SLDPRT

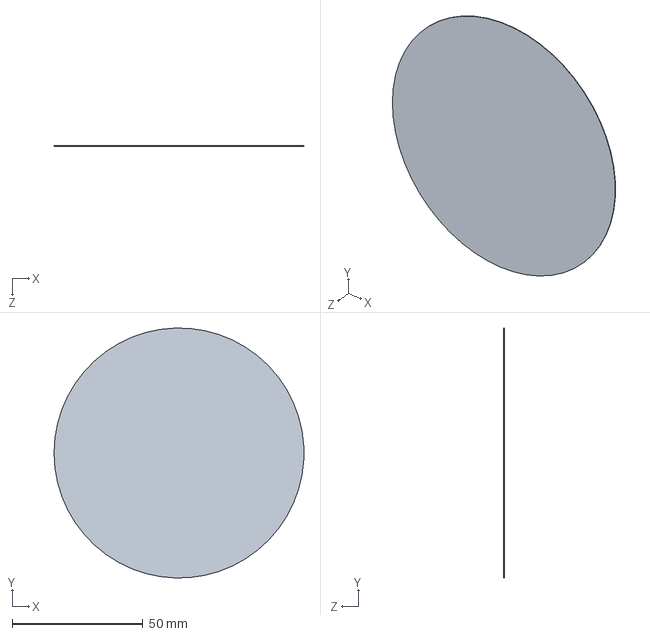
[picture p49: CAD file, 2020-11-07]
4 - Mechanical/01Design/Box Front paper.SLDPRT
95.5 x 95.5 x 0.2 mm
