Yourigh/A_light/(list of files, cad)

Other CAD files:
4 - Mechanical/source_models_/Header SSM-104-L-DV/SOLIDWORKS/SSM_104_L_DV.sldasm
4 - Mechanical/01Design/Alight_main_board_v2.SLDPRT
4 - Mechanical/02Export/clock face drawing.DWG
4 - Mechanical/03ClockFace/clock face drawing_small.dwg
4 - Mechanical/01Design/Box back.SLDPRT
4 - Mechanical/02Export/190724 final4 FRA/Box back.STL
4 - Mechanical/source_models_/Header SSM-104-L-DV/SOLIDWORKS/_SSM_104_L_DV_body_2.sldprt
4 - Mechanical/01Design/Submodels/ESP8266 single.SLDPRT
4 - Mechanical/02Export/181226 final2 clock parts print/Box back v2.SLDPRT
4 - Mechanical/02Export/190724 final4 FRA/Box back cover.STL
4 - Mechanical/source_models_/Header SSM-104-L-DV/SOLIDWORKS/_C_137_014_4.sldprt
4 - Mechanical/02Export/181226 final2 clock parts print/Box cover front.SLDPRT
4 - Mechanical/02Export/190724 final4 FRA/Box cover front ring.STL
4 - Mechanical/01Design/Box cover front no chamfer.SLDPRT
4 - Mechanical/01Design/Box cover front.SLDPRT
4 - Mechanical/01Design/LED ring 12 TZT.SLDPRT
4 - Mechanical/01Design/LED ring 24 TZT v2.SLDPRT
4 - Mechanical/01Design/MainPCB.SLDDRW
4 - Mechanical/02Export/181226 final2 clock parts print/Box back cover.STL
4 - Mechanical/02Export/181226 final2 clock parts print/Box back v2.STL
4 - Mechanical/02Export/181226 final2 clock parts print/Box cover front ring.STL
4 - Mechanical/02Export/181228 final3 clock/Box back cover.STL
4 - Mechanical/02Export/181228 final3 clock/Box back v3.STL
4 - Mechanical/02Export/181228 final3 clock/Box cover front ring.STL
4 - Mechanical/02Export/181228 final3 clock/Box cover front_old.SLDPRT
4 - Mechanical/02Export/MainPCB.DWG
4 - Mechanical/02Export/clock face drawing.SLDDRW
4 - Mechanical/source_models_/adafruit-neopixel-ring-12x-ws2812-rgb-leds-1.snapshot.1/Adafruit neopixel ring.igs
4 - Mechanical/source_models_/adafruit-neopixel-ring-12x-ws2812-rgb-leds-1.snapshot.1/Neopixel Ring 12x.x_t
4 - Mechanical/source_models_/esp32-wroom-1.snapshot.2/esp32wroom.x_t
4 - Mechanical/source_models_/header-female-1.snapshot.4/Header Female 1x10.SLDPRT
4 - Mechanical/source_models_/header-female-1.snapshot.4/Header Female 1x16.SLDPRT
4 - Mechanical/source_models_/neopixel-ring-24x-1.snapshot.6/Neopixels_ring_x24.STL
4 - Mechanical/source_models_/neopixel-ring-24x-1.snapshot.6/Neopixels_ring_x24.x_t
