Yourigh/A_light/2 - Electrical/0 - Development Drawings/2 - Main Board/1 - Schematics/190103_A_light_schematics main variant REV5 fixes.pdf

A

A

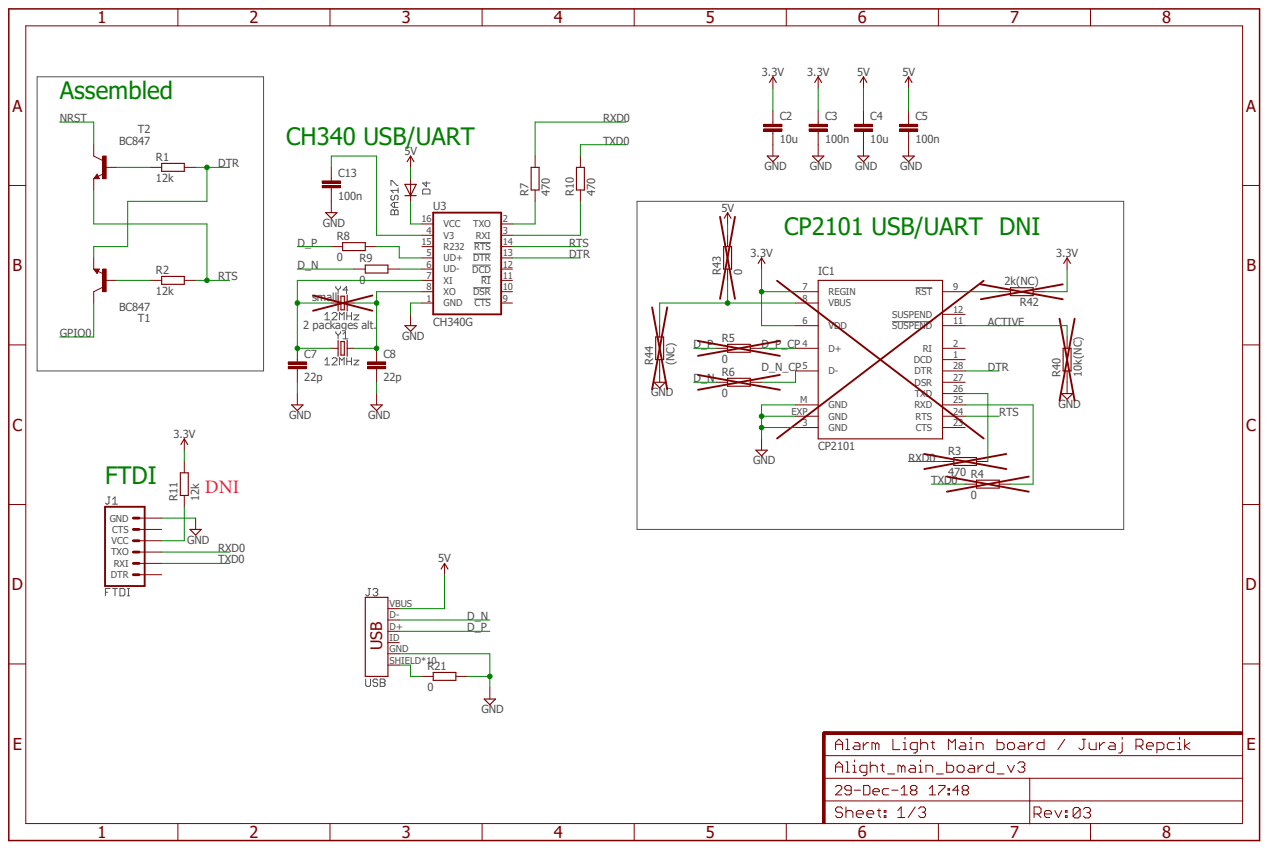
[picture p50: page 1]

# GND ¹²k

A

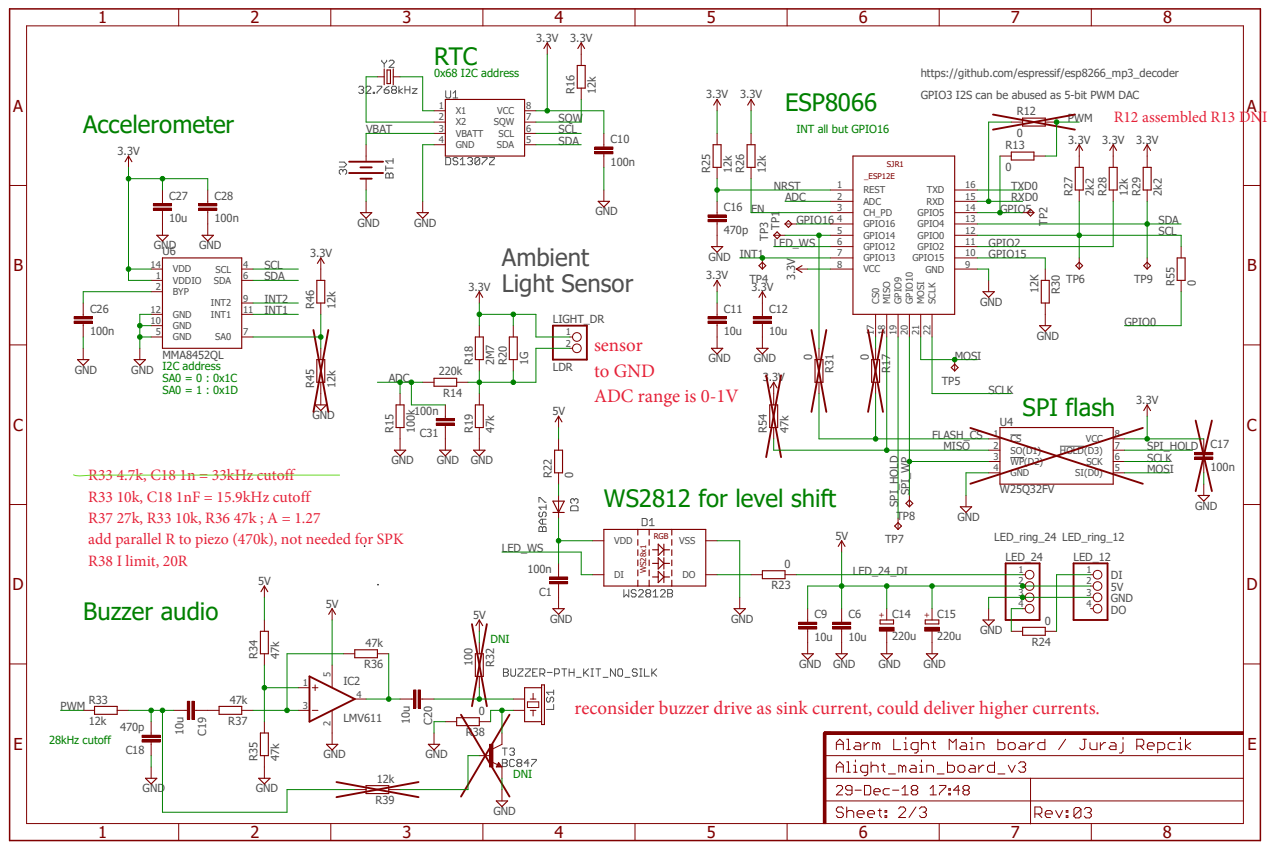
[picture p51: page 2]

https://github.com/espressif/esp8266_mp3_decoder
GPIO3 I2S can be abused as 5-bit PWM DAC

INT1 ABCDE | 1 | 2 | 3 | 4 | 5 | 6 | 7 | 8 | ABCDE 1 | 2 | 3 | 4 | 5 | 6 | 7 | 8

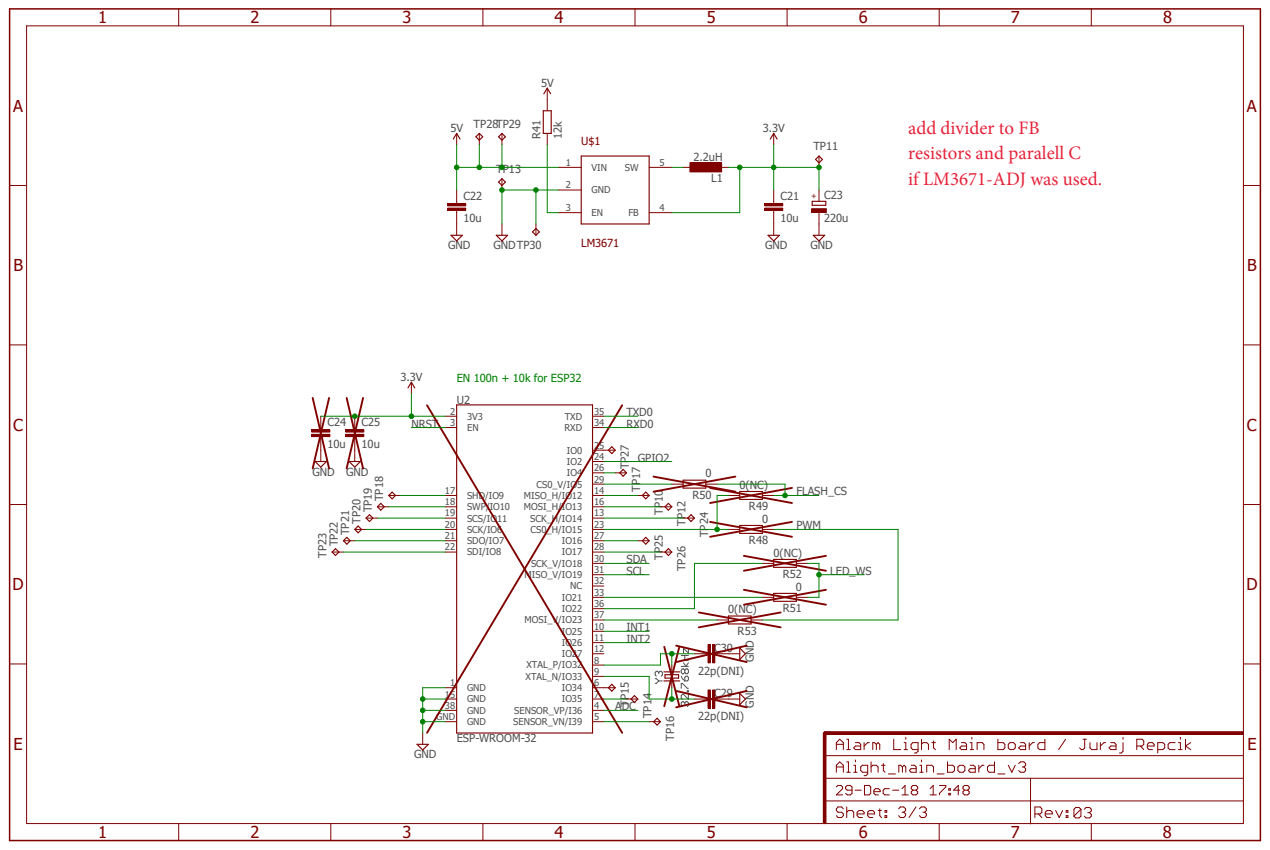
[picture p52: page 3]
