Yourigh/A_light/2 - Electrical/0 - Development Drawings/2 - Main Board/4 - Assembly Drawings/Assembly TOP.pdf

Z +5V
U6

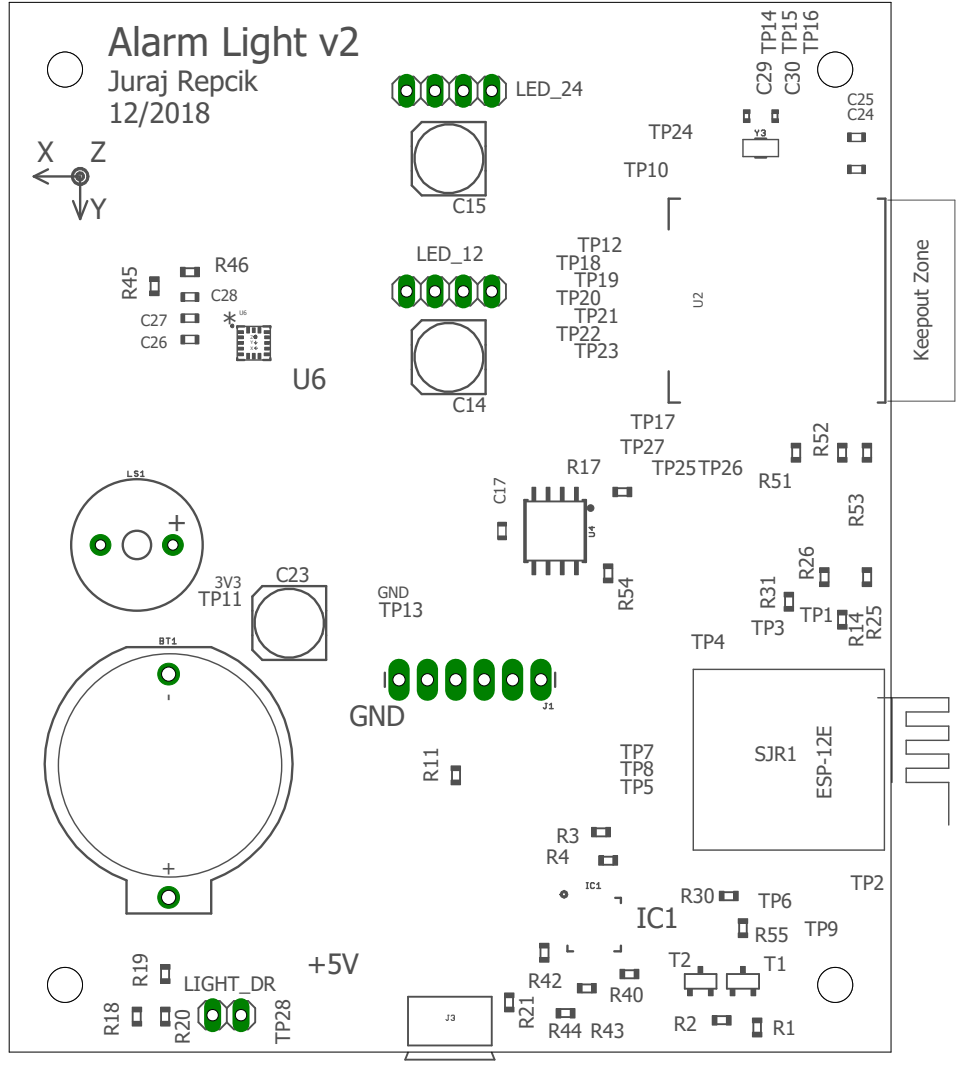
[picture p53: page 1]
