Yourigh/A_light/4 - Mechanical/02Export/clock face drawing.PDF

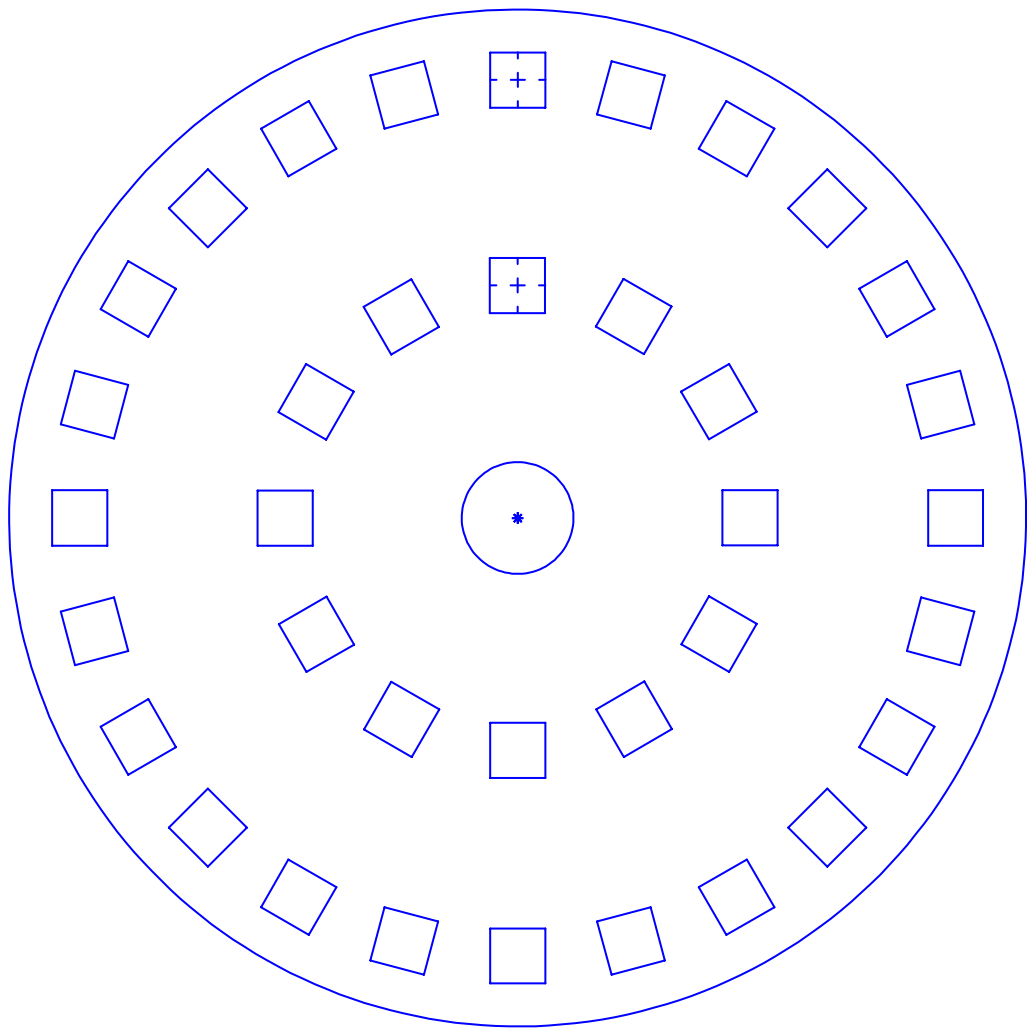
[picture p54: page 1]
