Yourigh/A_light/2 - Electrical/0 - Development Drawings/2 - Main Board/4 - Assembly Drawings/Assembly BOT mirrored.pdf

* U3

U1

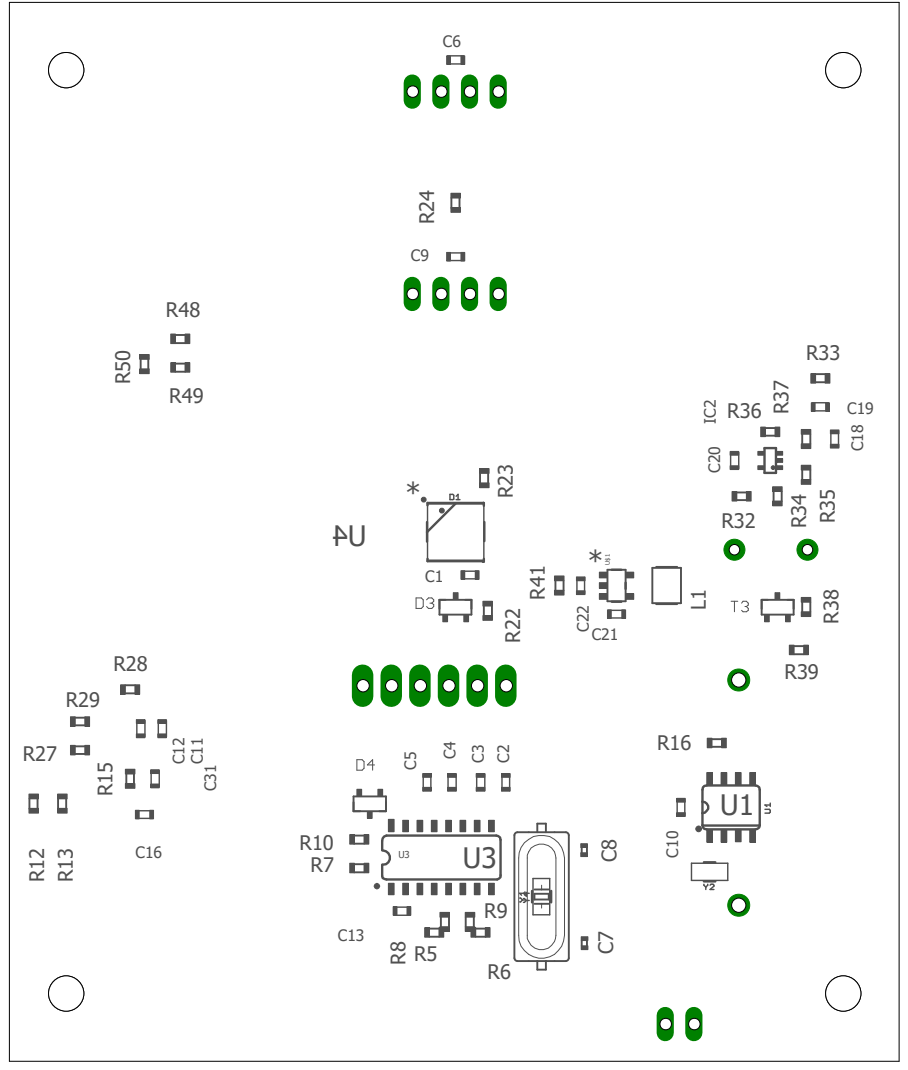
[picture p55: page 1]
