Yourigh/A_light/2 - Electrical/3 - Development sources/SparkFun_MMA8452Q-Breakout.pdf

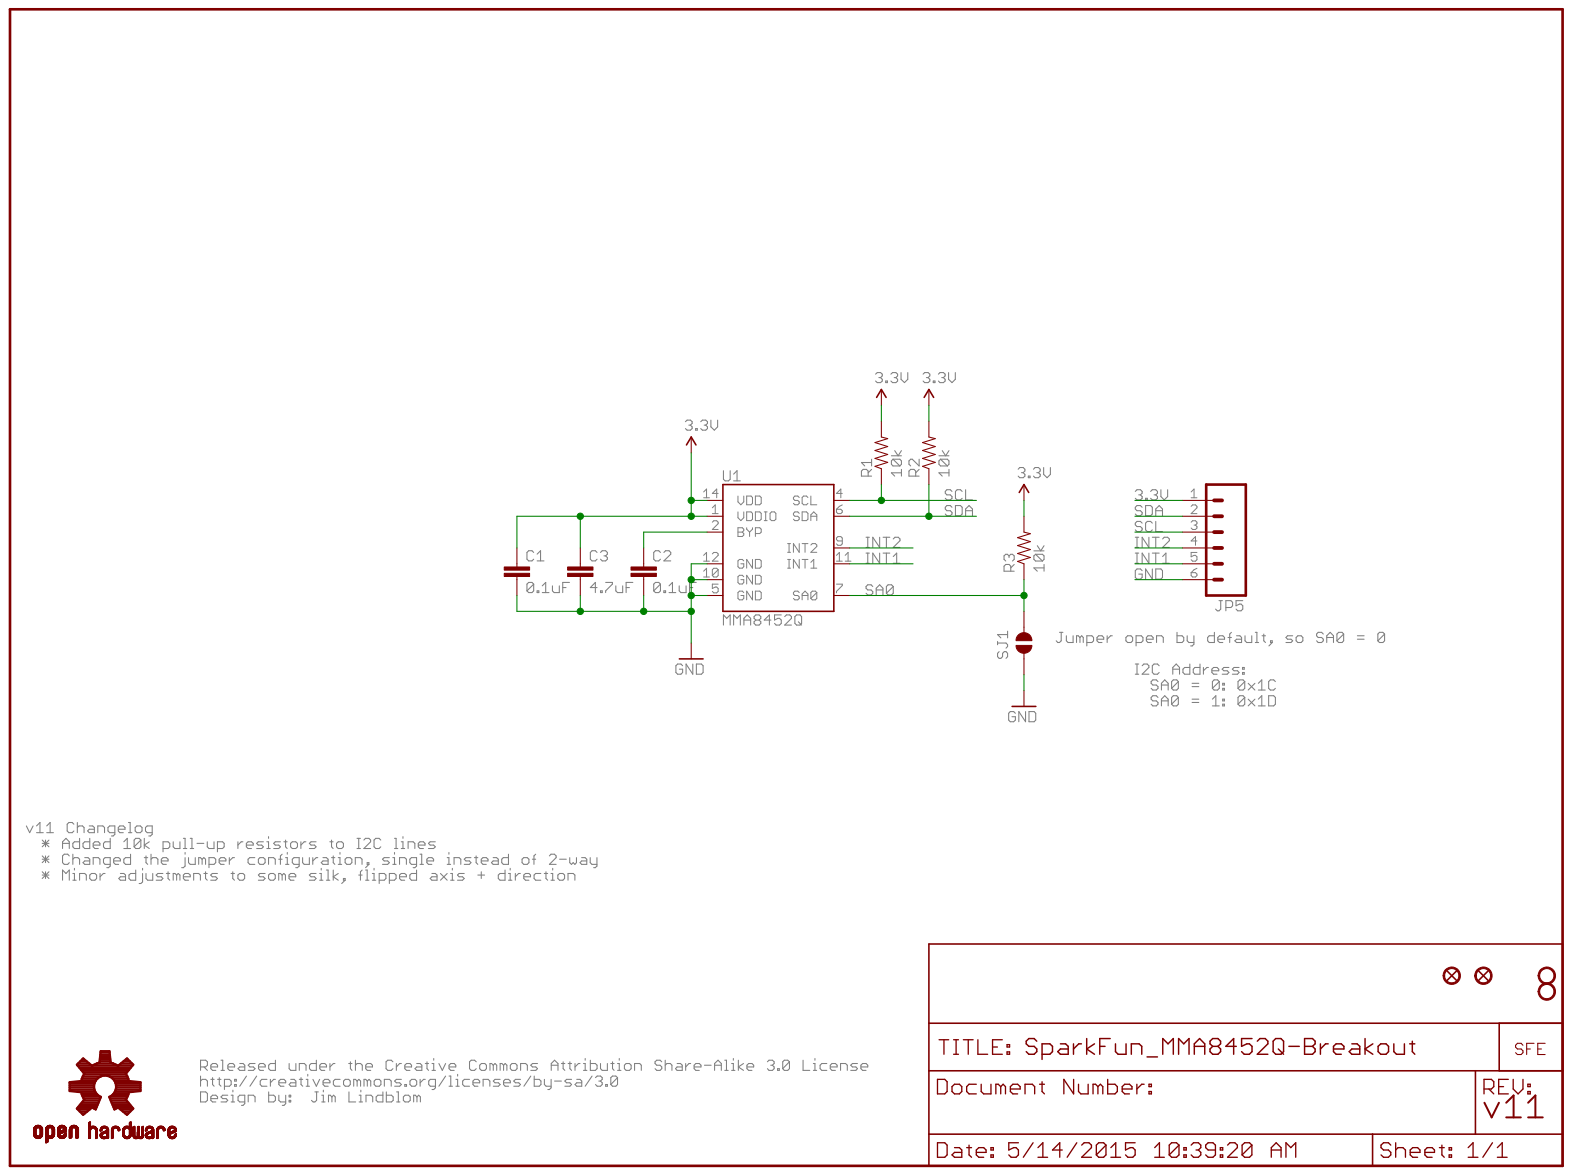
[picture p56: page 1]
