Yourigh/A_light/2 - Electrical/1 - Archive Production Drawings/2 - Main Board/1 - Schematics/1812229_A_light_schematics.pdf

A

A

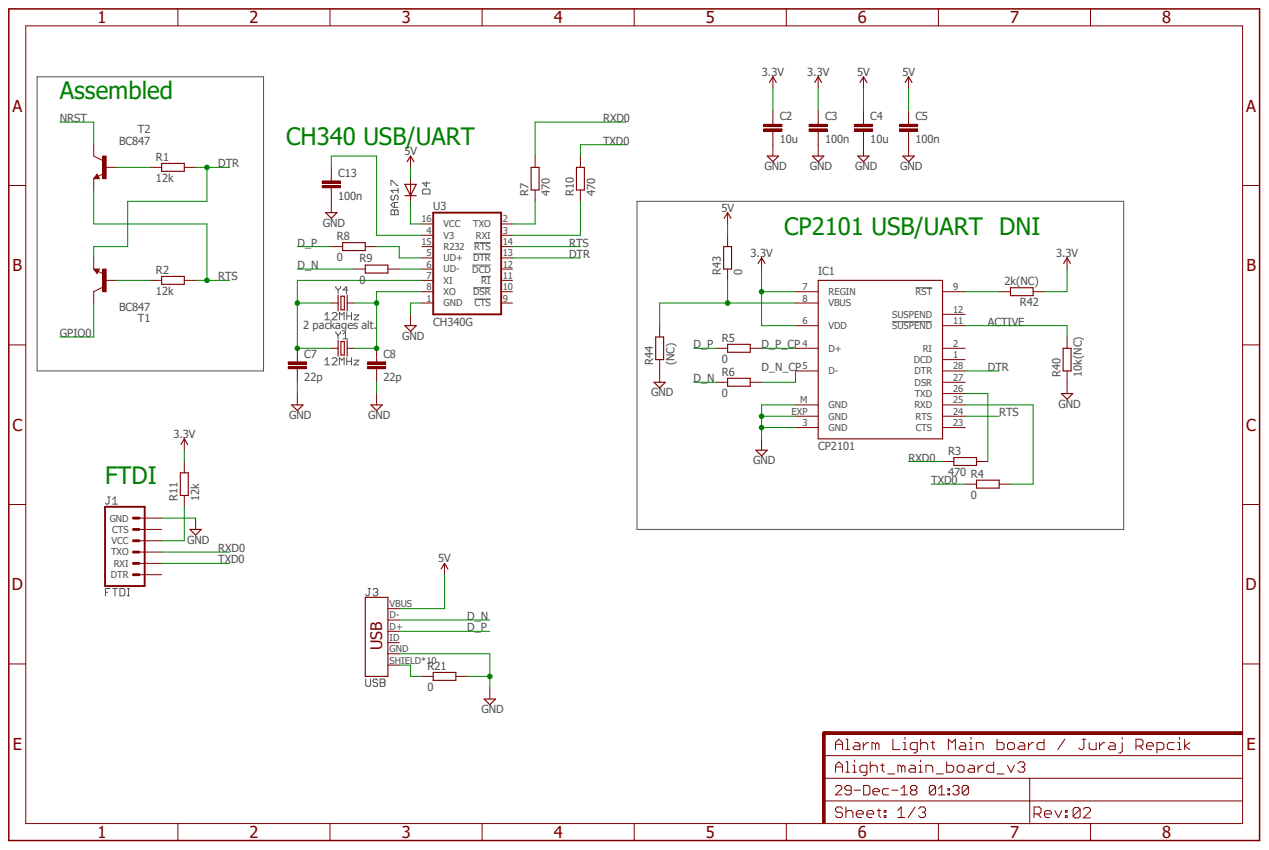
[picture p60: page 1]

# GND ¹²k

A

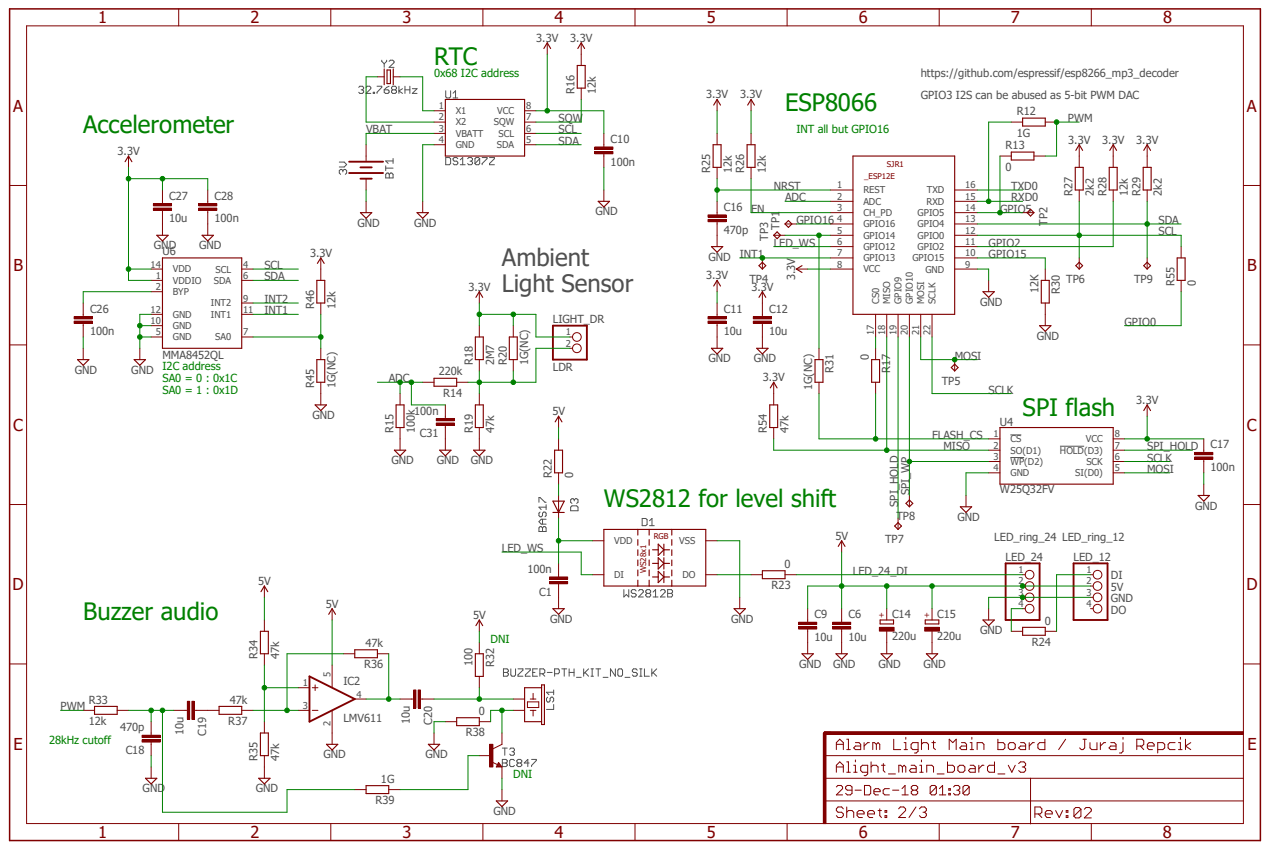
[picture p61: page 2]

https://github.com/espressif/esp8266_mp3_decoder
GPIO3 I2S can be abused as 5-bit PWM DAC

INT1 ABCDE | 1 | 2 | 3 | 4 | 5 | 6 | 7 | 8 | ABCDE 1 | 2 | 3 | 4 | 5 | 6 | 7 | 8

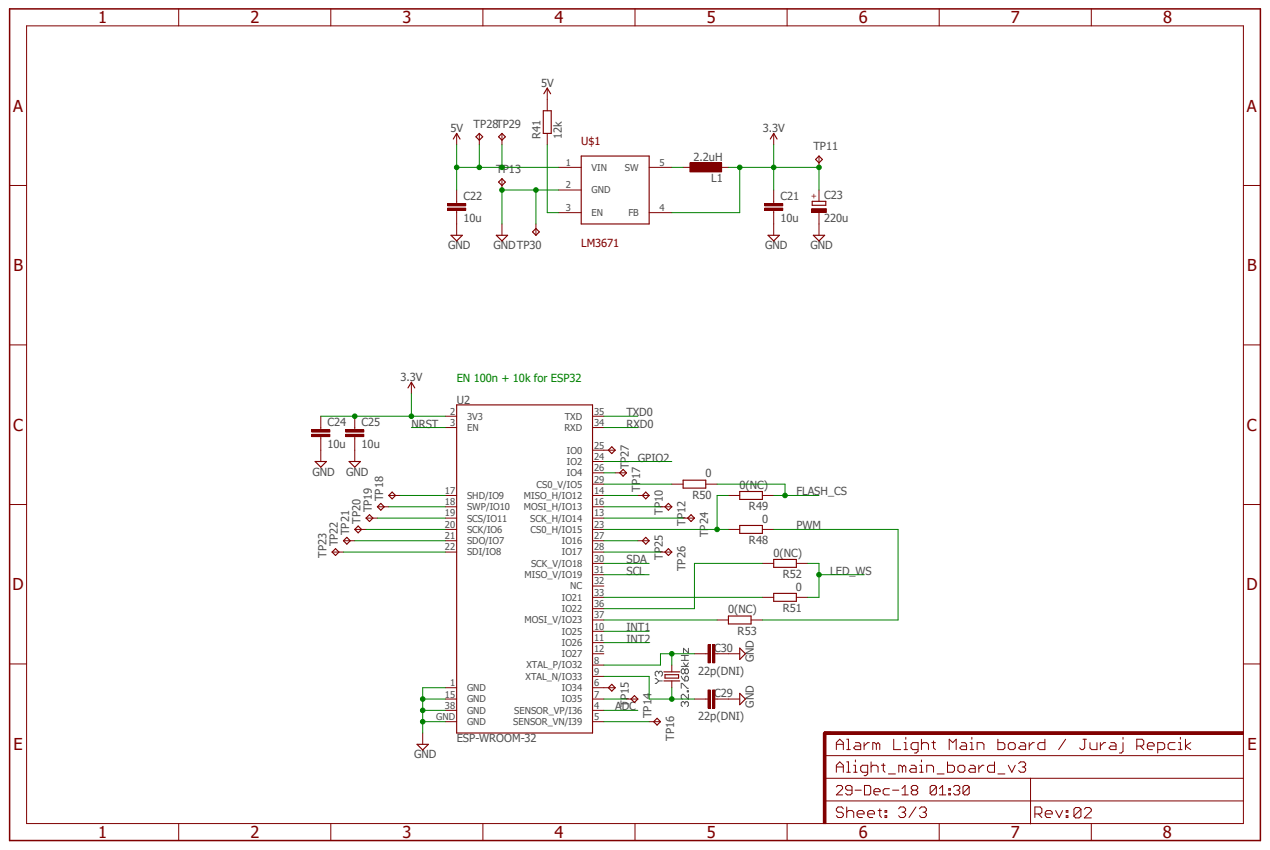
[picture p62: page 3]
