Yourigh/A_light/2 - Electrical/3 - Development sources/USB To Uart_3V3_Eagle/USB To Uart_3V3.brd

## EAGLE design 2 - Electrical/3 - Development sources/USB To Uart_3V3_Eagle/USB To Uart_3V3.brd (2020-11-07)

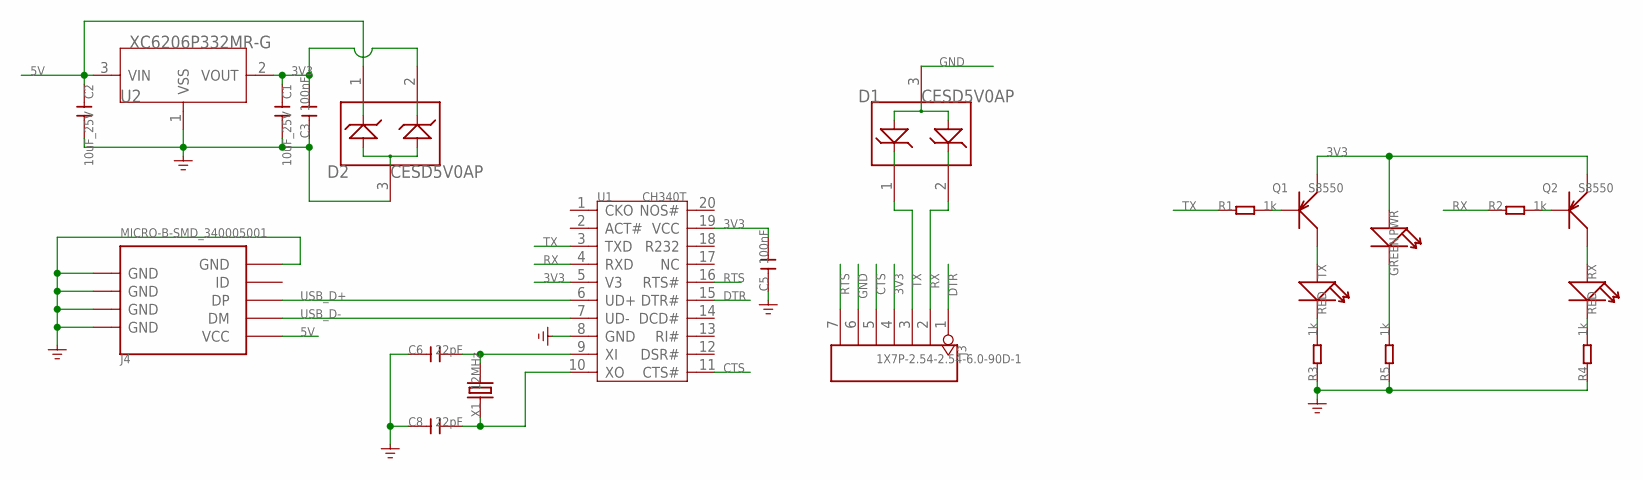
[picture p63: schematic USB To Uart_3V3.sch]

Parts:
C1, C2: 10uF_25V; C0805
C3, C5: 100nF; C0402
C6, C8: 22pF; C0402
D1, D2: CESD5V0AP; SOT23
J3: 1X7P-2.54-2.54-6.0-90D-1; 7P-2.54-65/35MIL
J4: MICRO-B-SMD_340005001; MICRO-USB
PWR: GREEN; LED-0603
Q1, Q2: S8550; SOT23
R1, R2, R3, R4, R5: 1k; R0402
RX: RED; LED-0603
TX: RED; LED-0603
U1: CH340T; SSOP20
U2: XC6206P332MR-G; SOT23
X1: 12MHz; HC49UP

Connections:
3V3: C1.1, C3.2, C5.2, D2.2, J3.4, PWR.+, Q1.2 (E), Q2.2 (E), U1.5 (V3), U1.19 (VCC), U2.2 (VOUT)
5V: C2.1, D2.1, J4.1 (VCC), U2.3 (VIN)
CTS: J3.5, U1.11 (CTS#)
DTR: J3.1, U1.15 (DTR#)
GND: C1.2, C2.2, C3.1, C5.1, C6.1, C8.1, D1.3, D2.3, J3.6, J4.5 (GND), J4.S1 (GND), J4.S2 (GND), J4.S3 (GND), J4.S4 (GND), J4.S5 (GND), J4.S6 (GND), R3.1, R4.1, R5.1, U1.8 (GND), U2.1 (VSS)
unnamed: Q1.3 (C), TX.+
unnamed: Q2.3 (C), RX.+
unnamed: C6.2, U1.9 (XI), X1.2
unnamed: C8.2, U1.10 (XO), X1.1
unnamed: R3.2, TX.-
unnamed: Q1.1 (B), R1.2
unnamed: Q2.1 (B), R2.2
unnamed: R4.2, RX.-
unnamed: PWR.-, R5.2
RTS: J3.7, U1.16 (RTS#)
RX: D1.2, J3.2, R2.1, U1.4 (RXD)
TX: D1.1, J3.3, R1.1, U1.3 (TXD)
USB_D+: J4.3 (DP), U1.6 (UD+)
USB_D-: J4.2 (DM), U1.7 (UD-)

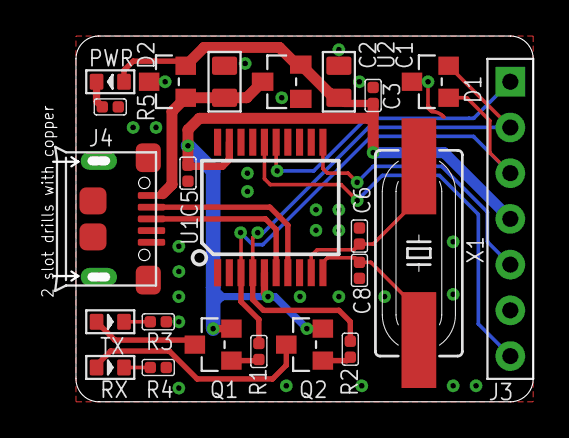
[picture p64: board USB To Uart_3V3.brd from above]

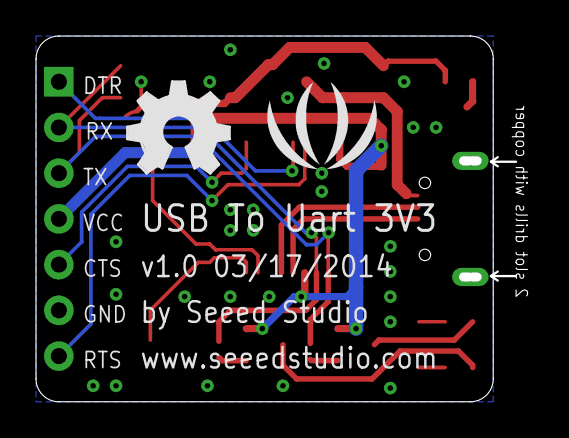
[picture p65: board USB To Uart_3V3.brd from below]

Board: 2 copper layers, 26.7 x 20.3 mm, 25 parts (2 on the bottom side), 19 nets.

Other parts of the board:
U$8: LOGO_SILK
U$9: OSHW_FILLX200_NOTEXT
