Yourigh/A_light/2 - Electrical/0 - Development Drawings/2 - Main Board/5 - CAD project/181225 Alight/Alight_main_board_v3.brd

## EAGLE design 2 - Electrical/0 - Development Drawings/2 - Main Board/5 - CAD project/181225 Alight/Alight_main_board_v3.brd (2020-11-07)

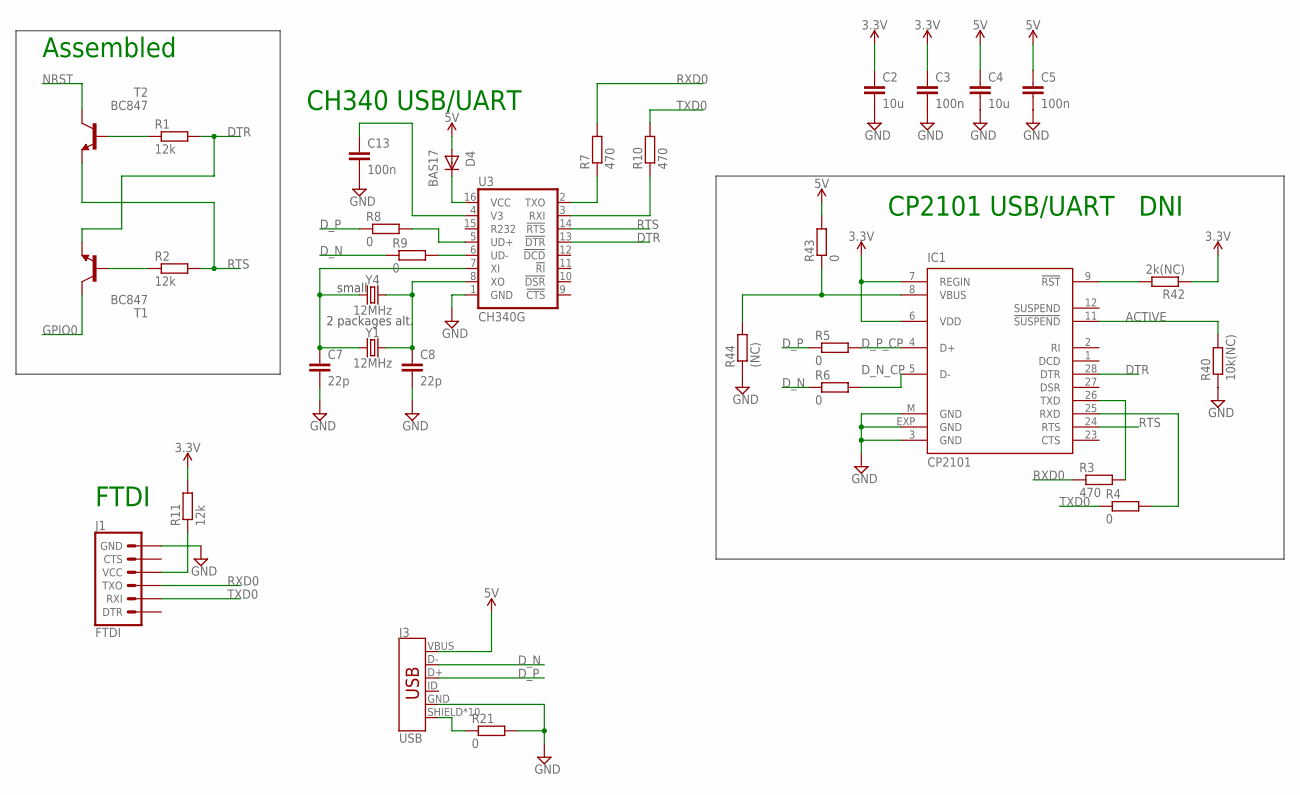
[picture p66: schematic Alight_main_board_v3.sch, sheet 1]

Parts:
C2, C4: 10u; C0603K
C3, C5, C13: 100n; C0603K
C7, C8: 22p; C0402
D4: BAS17; SOT23
IC1: CP2101; MLP28
J1: FTDI; 1X06_LONGPADS
J3: USB; USB-MICROB-PTH-MILL
R1, R2, R11: 12k; R0603
R3, R7, R10: 470; R0603
R4, R5, R6, R8, R9, R21, R43: 0; R0603
R40: 10k(NC); R0603
R42: 2k(NC); R0603
R44: (NC); R0603
T1, T2: BC847; SOT23
U3: CH340G; SO016
Y1: 12MHz; HC49UP
Y4: 12MHz; CRYSTAL-SMD-3.2X1.5MM

Connections:
3.3V: C2.1, C3.1, IC1.6 (VDD), IC1.7 (REGIN), R11.2, R42.1; also elsewhere on the board
5V: C4.1, C5.1, D4.1 (A), J3.VBUS, R43.2; also elsewhere on the board
ACTIVE: IC1.11 (!SUSPEND), R40.2
DTR: IC1.28 (DTR), R1.2, T1.2 (E), U3.13 (!DTR)
D_N: J3.D-, R6.1, R9.1
D_N_CP: IC1.5 (D-), R6.2
D_P: J3.D+, R5.1, R8.1
D_P_CP: IC1.4 (D+), R5.2
GND: C2.2, C3.2, C4.2, C5.2, C7.2, C8.2, C13.2, IC1.3 (GND), IC1.EXP (GND), IC1.M (GND), J1.6 (GND), J3.GND, R21.2, R40.1, R44.1, U3.1 (GND); also elsewhere on the board
GPIO0: T1.3 (C); also elsewhere on the board
unnamed: R1.1, T2.1 (B)
unnamed: R2.1, T1.1 (B)
unnamed: R7.1, U3.2 (TXO)
unnamed: R10.1, U3.3 (RXI)
unnamed: R8.2, U3.5 (UD+)
unnamed: R9.2, U3.6 (UD-)
unnamed: C7.1, U3.7 (XI), Y1.1, Y4.P$1 (1)
unnamed: C13.1, U3.4 (V3)
unnamed: C8.1, U3.8 (XO), Y1.2, Y4.P$2 (2)
unnamed: J1.4 (VCC), R11.1
unnamed: D4.3 (K), U3.16 (VCC)
unnamed: IC1.9 (!RST), R42.2
unnamed: IC1.8 (VBUS), R43.1, R44.2
NRST: T2.3 (C); also elsewhere on the board
RTS: IC1.24 (RTS), R2.2, T2.2 (E), U3.14 (!RTS)
RXD0: J1.3 (TXO), R3.1, R7.2; also elsewhere on the board
RXD0_CP2101IN: IC1.26 (TXD), R3.2
SHIELD: J3.SHIELD, J3.SHIELD2 (SHIELD), J3.SHIELD3 (SHIELD), J3.SHIELD4 (SHIELD), J3.SHIELD5 (SHIELD), J3.SHIELD6 (SHIELD), J3.SHIELD7 (SHIELD), J3.SHIELD8 (SHIELD), J3.SHIELD9 (SHIELD), J3.SHIELD10 (SHIELD), R21.1
TXD0: J1.2 (RXI), R4.1, R10.2; also elsewhere on the board
TXD0_CP2101: IC1.25 (RXD), R4.2

Notes on the sheet:
CH340 USB/UART
CP2101 USB/UART
FTDI
Assembled
DNI
2 packages alt.
small

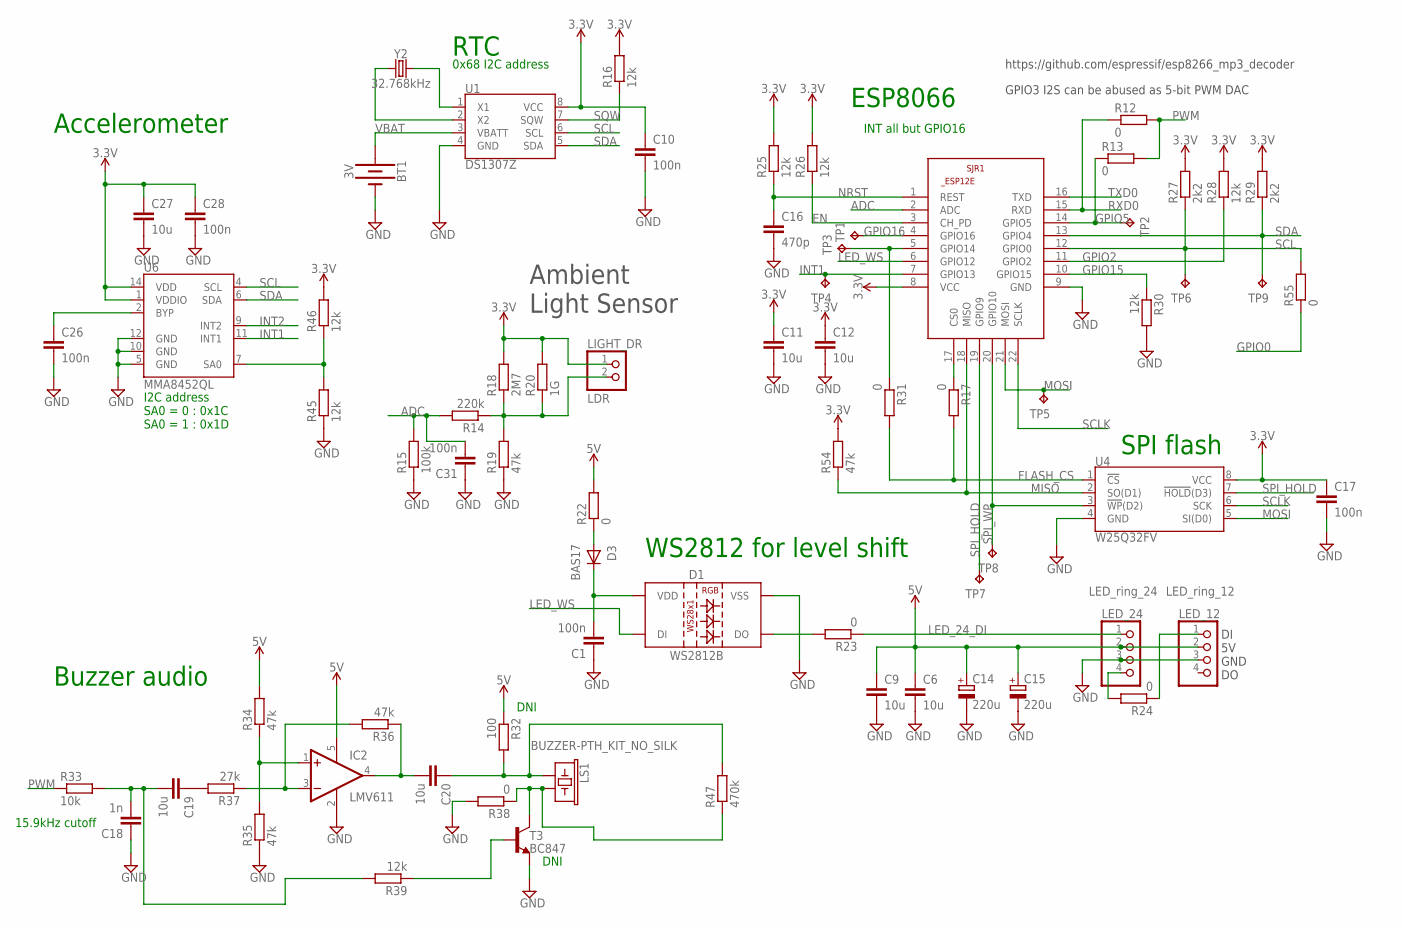
[picture p67: schematic Alight_main_board_v3.sch, sheet 2]

Parts:
BT1: 3V; BATTCOM_20MM_PTH_KIT
C1, C10, C17, C26, C28, C31: 100n; C0603K
C6, C9, C11, C12, C19, C20, C27: 10u; C0603K
C14, C15: 220u; 153CLV-0605
C16: 470p; C0603K
C18: 1n; C0603K
D1: WS2812B
D3: BAS17; SOT23
IC2: LMV611; SC70-5L
LED_12: LED_ring_12; 1X04
LED_24: LED_ring_24; 1X04
LIGHT_DR: LDR; 1X02
LS1: BUZZER-PTH_KIT_NO_SILK; BUZZER-12MM-NS-KIT
R12, R13, R17, R22, R23, R24, R31, R38, R55: 0; R0603
R14: 220k; R0603
R15: 100k; R0603
R16, R25, R26, R28, R30, R39, R45, R46: 12k; R0603
R18: 2M7; R0603
R19, R34, R35, R36, R54: 47k; R0603
R20: 1G; R0603
R27, R29: 2k2; R0603
R32: 100; R0603
R33: 10k; R0603
R37: 27k; R0603
R47: 470k; R0603
SJR1: ESP12E/F; ESP8266-ESP12E
T3: BC847; SOT23
TP1, TP2, TP3, TP4, TP5, TP6, TP7, TP8, TP9: TPTP10R; TP10R
U1: DS1307Z; SO08-0.15
U4: W25Q32FV; SOIC-8
U6: MMA8452QL; QFN-16_0.5MM-EXTRA
Y2: 32.768kHz; CRYSTAL-SMD-3.2X1.5MM

Connections:
3.3V: C10.1, C11.1, C12.1, C17.1, C27.1, C28.1, LIGHT_DR.1, R16.2, R18.2, R20.2, R25.2, R26.2, R27.2, R28.2, R29.2, R46.2, R54.2, SJR1.8 (VCC), U1.8 (VCC), U4.8 (VCC), U6.1 (VDDIO), U6.14 (VDD); also elsewhere on the board
5V: C6.1, C9.1, C14.+, C15.+, IC2.5 (V+), LED_12.2, LED_24.2, R22.2, R32.1, R34.2; also elsewhere on the board
ADC: C31.2, R14.2, R15.2, SJR1.2 (ADC); also elsewhere on the board
EN: R26.1, SJR1.3 (CH_PD)
FLASH_CS: R17.2, R31.2, U4.1 (!CS!); also elsewhere on the board
GND: BT1.2 (-), C1.1, C6.2, C9.2, C10.2, C11.2, C12.2, C14.-, C15.-, C16.2, C17.2, C18.1, C26.2, C27.2, C28.2, C31.1, D1.3 (VSS), IC2.2 (V-), LED_12.3, LED_24.3, R15.1, R19.1, R30.2, R35.1, R38.2, R45.1, SJR1.9 (GND), T3.2 (E), U1.4 (GND), U4.4 (GND), U6.5 (GND), U6.10 (GND), U6.12 (GND); also elsewhere on the board
GPIO0: R55.1; also elsewhere on the board
GPIO2: R28.1, SJR1.11 (GPIO2); also elsewhere on the board
GPIO5: R13.1, SJR1.14 (GPIO5), TP2.TP
GPIO15: R30.1, SJR1.10 (GPIO15)
GPIO16: SJR1.4 (GPIO16), TP1.TP
INT1: SJR1.7 (GPIO13), TP4.TP, U6.11 (INT1); also elsewhere on the board
INT2: U6.9 (INT2); also elsewhere on the board
LED_12DI: LED_12.1, R24.1
LED_24_DI: LED_24.1, R23.1
LED_24_DO: LED_24.4, R24.2
LED_WS: D1.4 (DI), SJR1.6 (GPIO12); also elsewhere on the board
MISO: R54.1, SJR1.18 (MISO), U4.2 (SO(D1))
MOSI: SJR1.21 (MOSI), TP5.TP, U4.5 (SI(D0))
unnamed: C1.2, D1.1 (VDD), D3.3 (K)
unnamed: LIGHT_DR.2, R14.1, R18.1, R19.2, R20.1
unnamed: D3.1 (A), R22.1
unnamed: D1.2 (DO), R23.2
unnamed: C26.1, U6.2 (BYP)
unnamed: R31.1, SJR1.5 (GPIO14), TP3.TP
unnamed: R17.1, SJR1.17 (CS0)
unnamed: LS1.- (2), R38.1, R47.1, T3.3 (C)
unnamed: R39.1, T3.1 (B)
unnamed: IC2.1 (+IN), R34.1, R35.2
unnamed: U1.1 (X1), Y2.P$2 (2)
unnamed: U1.2 (X2), Y2.P$1 (1)
unnamed: IC2.3 (-IN), R36.2, R37.1
unnamed: C20.1, LS1.+ (1), R32.2, R47.2
unnamed: C19.1, R37.2
unnamed: C20.2, IC2.4 (OUT), R36.1
unnamed: C18.2, C19.2, R33.2, R39.2
unnamed: R45.2, R46.1, U6.7 (SA0)
NRST: C16.1, R25.1, SJR1.1 (REST); also elsewhere on the board
PWM: R12.2, R13.2, R33.1; also elsewhere on the board
RXD0: R12.1, SJR1.15 (RXD); also elsewhere on the board
SCL: R27.1, R55.2, SJR1.12 (GPIO0), TP6.TP, U1.6 (SCL), U6.4 (SCL); also elsewhere on the board
SCLK: SJR1.22 (SCLK), U4.6 (SCK)
SDA: R29.1, SJR1.13 (GPIO4), TP9.TP, U1.5 (SDA), U6.6 (SDA); also elsewhere on the board
SPI_HOLD: SJR1.19 (GPIO9), TP7.TP, U4.7 (!HOLD!(D3))
SPI_WP: SJR1.20 (GPIO10), TP8.TP, U4.3 (!WP!(D2))
SQW: R16.1, U1.7 (SQW)
TXD0: SJR1.16 (TXD); also elsewhere on the board
VBAT: BT1.1 (+), U1.3 (VBATT)

Notes on the sheet:
Ambient Light Sensor
DI 5V GND DO
GPIO3 I2S can be abused as 5-bit PWM DAC
https://github.com/espressif/esp8266_mp3_decoder
0x68 I2C address
INT all but GPIO16
15.9kHz cutoff
DNI
RTC
ESP8066
WS2812 for level shift
Buzzer audio
SPI flash
I2C address SA0 = 0 : 0x1C SA0 = 1 : 0x1D
Accelerometer

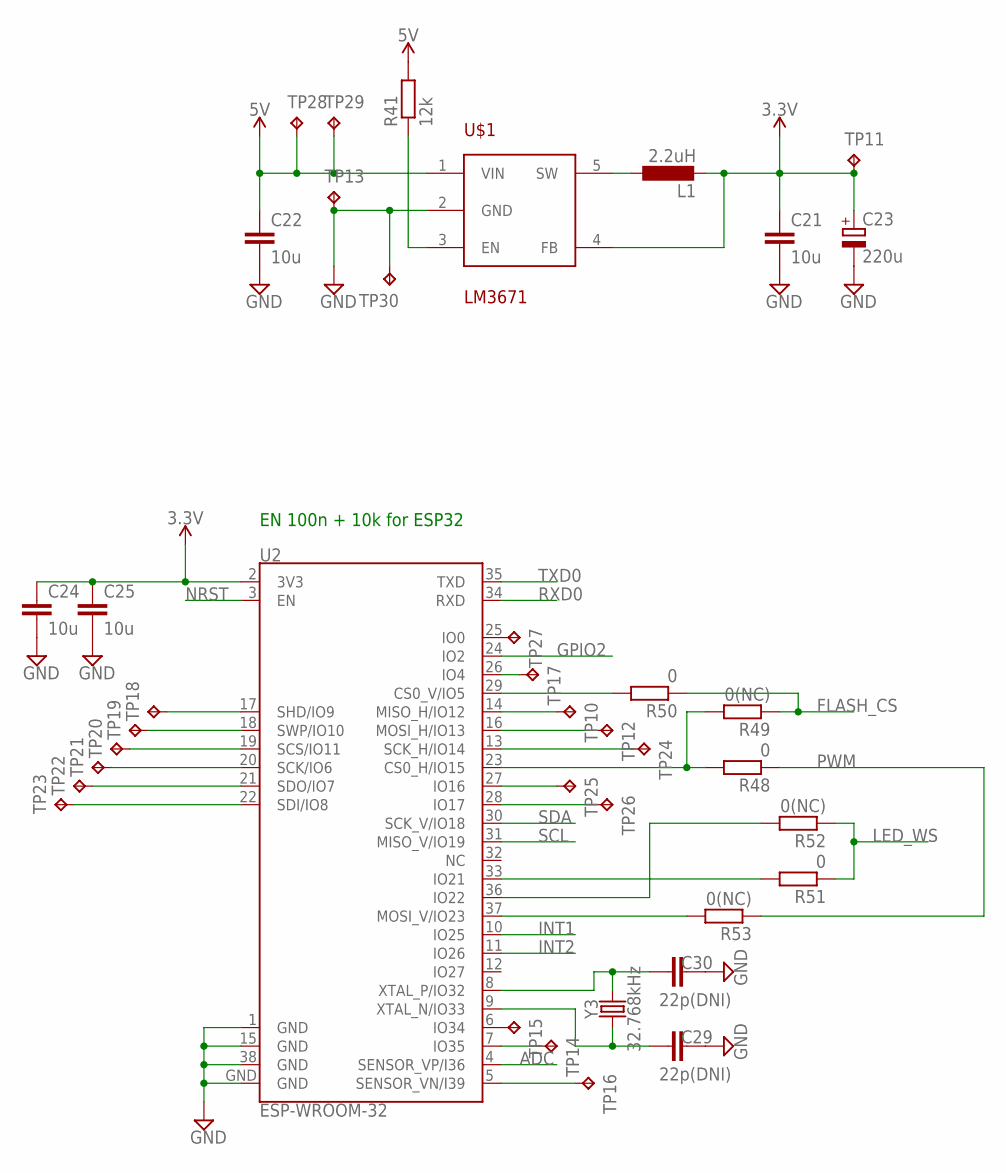
[picture p68: schematic Alight_main_board_v3.sch, sheet 3]

Parts:
C21, C22, C24, C25: 10u; C0603K
C23: 220u; 153CLV-0605
C29, C30: 22p(DNI); C0402
L1: 2.2uH; L3225M
R41: 12k; R0603
R48, R50, R51: 0; R0603
R49, R52, R53: 0(NC); R0603
TP10, TP11, TP12, TP13, TP14, TP15, TP16, TP17, TP18, TP19, TP20, TP21, TP22, TP23, TP24, TP25, TP26, TP27, TP28, TP29, TP30: TPTP10R; TP10R
U2: ESP-WROOM-32
U$1: LM3671; SOT23-5
Y3: 32.768kHz; CRYSTAL-SMD-3.2X1.5MM

Connections:
3.3V: C21.1, C23.+, C24.1, C25.1, L1.2, TP11.TP, U2.2 (3V3), U$1.4 (FB); also elsewhere on the board
5V: C22.1, R41.2, TP28.TP, TP29.TP, U$1.1 (VIN); also elsewhere on the board
ADC: U2.4 (SENSOR_VP/I36); also elsewhere on the board
FLASH_CS: R49.1, R50.1; also elsewhere on the board
GND: C21.2, C22.2, C23.-, C24.2, C25.2, C29.2, C30.2, TP13.TP, TP30.TP, U2.1 (GND), U2.15 (GND), U2.38 (GND), U2.GND, U$1.2 (GND); also elsewhere on the board
GPIO2: U2.24 (IO2); also elsewhere on the board
INT1: U2.10 (IO25); also elsewhere on the board
INT2: U2.11 (IO26); also elsewhere on the board
LED_WS: R51.1, R52.1; also elsewhere on the board
unnamed: C30.1, U2.8 (XTAL_P/IO32), Y3.P$2 (2)
unnamed: C29.1, U2.9 (XTAL_N/IO33), Y3.P$1 (1)
unnamed: R48.2, R49.2, U2.23 (CS0_H/IO15)
unnamed: R51.2, U2.33 (IO21)
unnamed: R52.2, U2.36 (IO22)
unnamed: R41.1, U$1.3 (EN)
unnamed: L1.1, U$1.5 (SW)
unnamed: R50.2, U2.29 (CS0_V/IO5)
unnamed: R53.2, U2.37 (MOSI_V/IO23)
unnamed: TP14.TP, U2.7 (IO35)
unnamed: TP15.TP, U2.6 (IO34)
unnamed: TP16.TP, U2.5 (SENSOR_VN/I39)
unnamed: TP17.TP, U2.26 (IO4)
unnamed: TP18.TP, U2.17 (SHD/IO9)
unnamed: TP19.TP, U2.18 (SWP/IO10)
unnamed: TP20.TP, U2.19 (SCS/IO11)
unnamed: TP21.TP, U2.20 (SCK/IO6)
unnamed: TP22.TP, U2.21 (SDO/IO7)
unnamed: TP23.TP, U2.22 (SDI/IO8)
unnamed: TP10.TP, U2.14 (MISO_H/IO12)
unnamed: TP12.TP, U2.16 (MOSI_H/IO13)
unnamed: TP24.TP, U2.13 (SCK_H/IO14)
unnamed: TP25.TP, U2.27 (IO16)
unnamed: TP26.TP, U2.28 (IO17)
unnamed: TP27.TP, U2.25 (IO0)
NRST: U2.3 (EN); also elsewhere on the board
PWM: R48.1, R53.1; also elsewhere on the board
RXD0: U2.34 (RXD); also elsewhere on the board
SCL: U2.31 (MISO_V/IO19); also elsewhere on the board
SDA: U2.30 (SCK_V/IO18); also elsewhere on the board
TXD0: U2.35 (TXD); also elsewhere on the board

Notes on the sheet:
EN 100n + 10k for ESP32

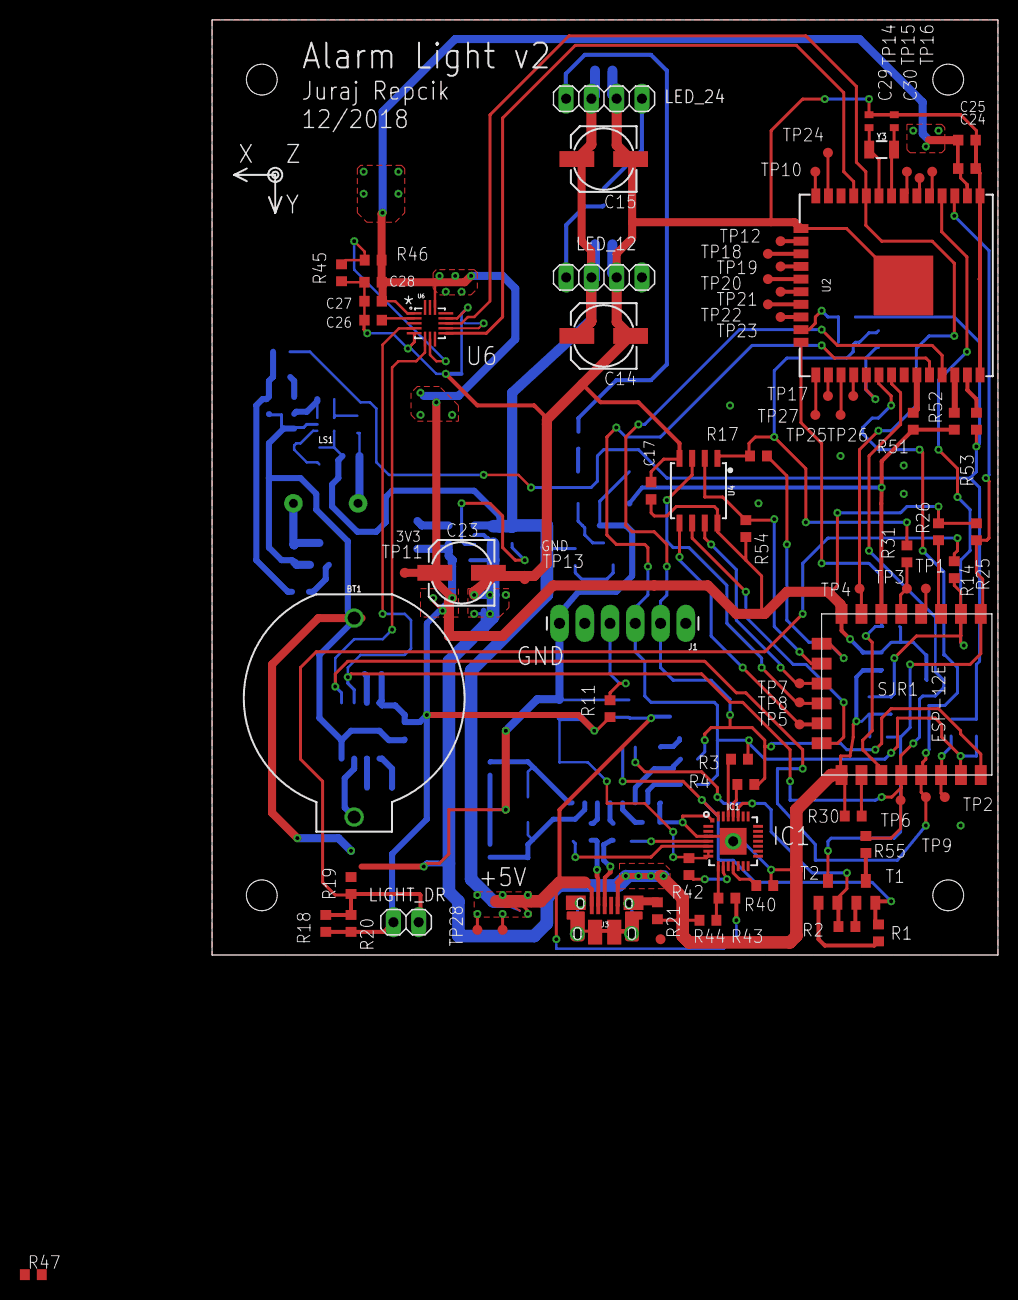
[picture p69: board Alight_main_board_v3.brd from above]

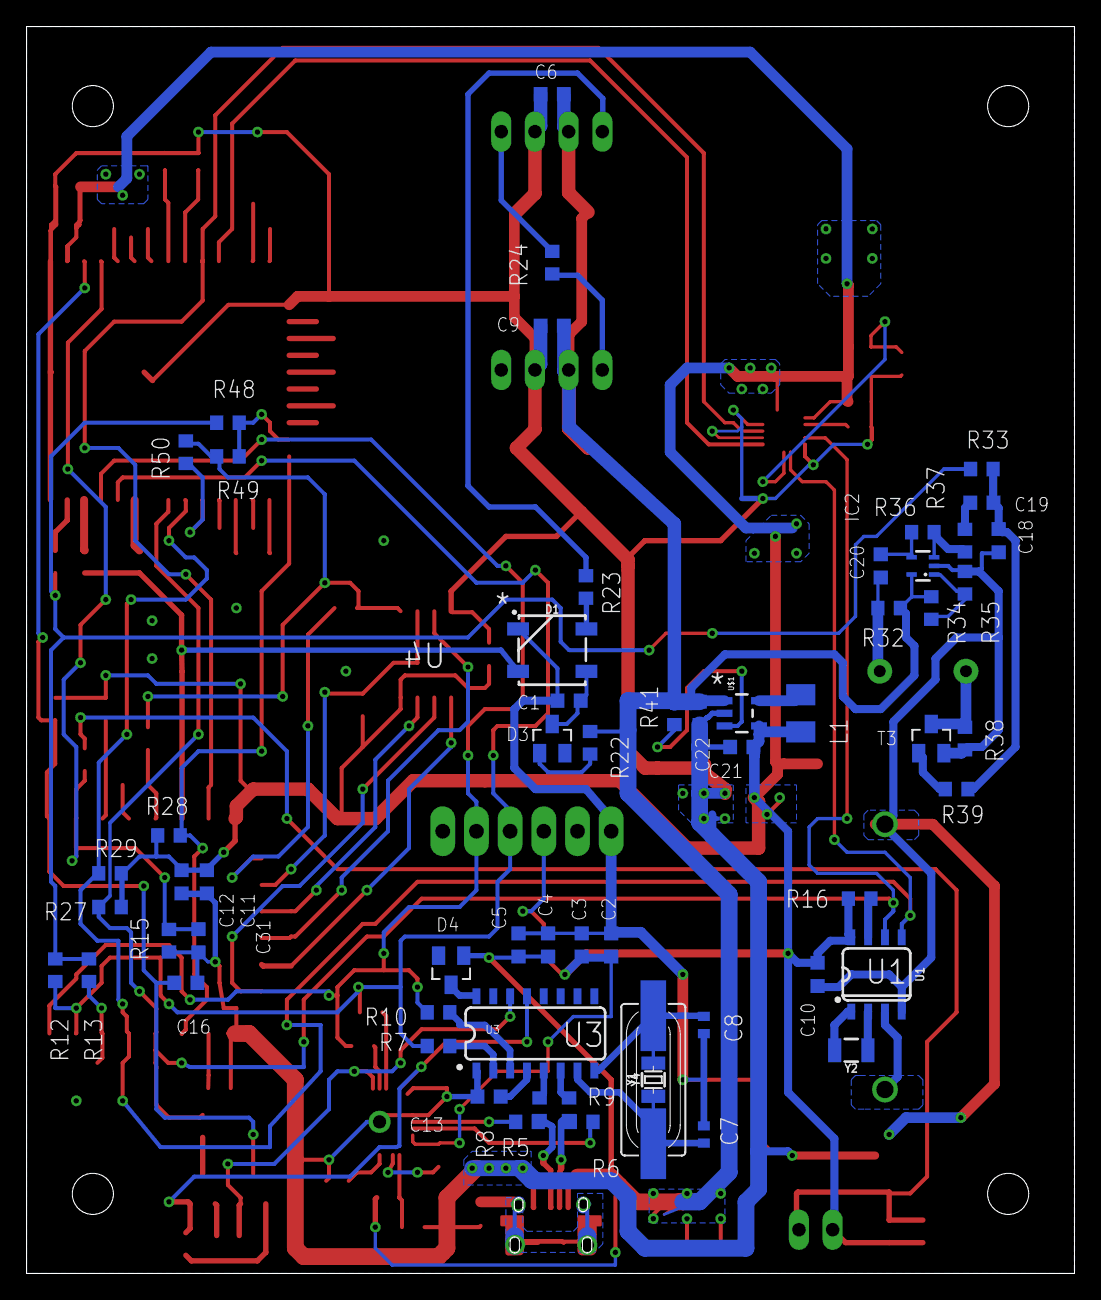
[picture p70: board Alight_main_board_v3.brd from below]

Board: 2 copper layers, 79.0 x 94.0 mm, 144 parts (60 on the bottom side), 96 nets.

Other parts of the board:
DRILEGEND: DRILEGEND
