Yourigh/A_light/3 - FW SW/3 - Development sources/_190103_I2S_wave/_190103_I2S_wave/_190103_I2S_wave.ino

#include "Arduino.h"
#include "ESP8266WiFi.h"
#include "i2s.h"
#include "i2s_reg.h"

int8_t wave[22050] = {
0xFC, 0xF8, 0x00, 0xFD, 0xFA, 0x01, 0xF6, 0x04, 0xFE, 0x01, 0xFE, 0xFF, 0xF9, 0x03, 0xFE, 0x07, 0x05, 0x07, 0x03, 0x02, 0x09, 0x06, 0x07, 0x02, 0x07, 0x01, 0xFE, 0xF7, 0xF3, 0xF9, 0x06, 0x10, 0x13, 0x19, 0x17, 0x1E, 0x2D, 0x4E, 0x59, 0x52, 0x4D, 0x45, 0x48, 0x48, 0x48, 0x44, 0x41, 0x3C, 0x3A, 0x32, 0x30, 0x32, 0x2B, 0x23, 0x22, 0x1D, 0x20, 0x22, 0x1B, 0x1D, 0x14, 0x0C, 0x03, 0x07, 0x01, 0xFB, 0xF1, 0xEC, 0xE4, 0xDD, 0xD8, 0xD1, 0xD1, 0xC9, 0xC7, 0xC1, 0xC5, 0xC3, 0xBC, 0xB9, 0xB4, 0xB7, 0xAE, 0xB3, 0xAD, 0xB0, 0xAD, 0xB1, 0xAF, 0xBA, 0xAA, 0xAE, 0xB1, 0xB3, 0xB8, 0xBB, 0xC3, 0xC2, 0xC0, 0xC1, 0xC3, 0xC9, 0xCA, 0xD0, 0xCC, 0xD6, 0xD7, 0xDA, 0xDB, 0xE7, 0xDC, 0xE6, 0xE2, 0xF3, 0xF3, 0xFF, 0x00, 0xFE, 0xFC, 0x0B, 0x18, 0x10, 0x21, 0x1B, 0x2C, 0x27, 0x37, 0x37, 0x41, 0x48, 0x4E, 0x46, 0x52, 0x54, 0x53, 0x59, 0x4E, 0x4D, 0x51, 0x4B, 0x43, 0x4E, 0x40, 0x41, 0x3D, 0x37, 0x3F, 0x38, 0x31, 0x30, 0x3A, 0x26, 0x3E, 0x25, 0x33, 0x2C, 0x31, 0x20, 0x24, 0x1B, 0x25, 0x0B, 0x0D, 0x07, 0xFD, 0x08, 0xF1, 0xFE, 0xEB, 0xF8, 0xEC, 0xEC, 0xF0, 0xE6, 0xE1, 0xDF, 0xDA, 0xD7, 0xCD, 0xC9, 0xC8, 0xCA, 0xC2, 0xC6, 0xBB, 0xC1, 0xB6, 0xB0, 0xBB, 0xB2, 0xAB, 0xB6, 0xB0, 0xAD, 0xB1, 0xB4, 0xBA, 0xB8, 0xBB, 0xC0, 0xB9, 0xC8, 0xB6, 0xC6, 0xCA, 0xD5, 0xD4, 0xDB, 0xCF, 0xDF, 0xE0, 0xE5, 0xDA, 0xE5, 0xE2, 0xF0, 0xF0, 0xF3, 0xF4, 0xF1, 0xEF, 0xF8, 0xFC, 0x0D, 0x0B, 0x04, 0xFE, 0x0B, 0x0E, 0x17, 0x16, 0x1E, 0x10, 0x22, 0x1B, 0x2C, 0x29, 0x29, 0x33, 0x34, 0x39, 0x41, 0x36, 0x46, 0x34, 0x3A, 0x44, 0x3C, 0x3E, 0x2F, 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
