Yourigh/A_light/3 - FW SW/2 - Alarm Clock FW ESP8266/_171209_next_alarm_multiple/Alight_web.h

#if !defined(ALIGHT_WEB)
#define ALIGHT_WEB 1

const char html_replace[]={
' ',//0
' ',//1
' ',//2
' ',//3
' ',//4
' ',//5
' ',//6
' ',//7
' ',//8
' ',//9
' ',//10
' ',//11
' ',//12
' ',//13
' ',//14
' ',//15
' ',//16
' ',//17
' ',//18
' ',//19
' ',//20
' ',//21
' ',//22
' ',//23
' ',//24
' ',//25
' ',//26
' ',//27
' ',//28
' ',//29
' ',//30
' ',//31
' ',//32
'!',//33
'"',//34
'#',//35
'$',//36
'%',//37
'&',//38
'\'',//39
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
};
//http://www.idautomation.com/product-support/ascii-chart-char-set.html

#endif
