Yourigh/A_light/(commit log)

2020-11-07 add code
    [181229 Alight_eeBOM.xlsx, 24 neopixel.SLDPRT, Adafruit LM3671 Buck.sch, Adafruit neopixel ring.igs, Adafruit neopixel ring.stp, Alight_main_board.brd, Alight_main_board.sch, Alight_main_board_v2.SLDPRT]
2020-11-07 increased delay on mDNS reponder
    less fails on boot
    [Alight_main.cpp]
2020-12-22 bug fix RTC error report
    [Alight_main.cpp]
2020-12-22 added summer time with EEPROm seving
    [DEV_notes_REV2.xlsx]
2025-09-19 fix http client, to be able to build. not tested
    [Alight_main.cpp]
2025-09-22 night mode edit - middle LED on.
